guthmanny/feahi_rp2350/hardware/profiles/sp-1/README.md

# SP-1 单板 Profile

量产 **4L 单板** KiCad 工程：RP2350、ESP32-C6、MS1808/MS4344、8080 屏、键灯、接口与电源。

## KiCad

打开：**File → Open Project** →  
[hardware/profiles/sp-1/kicad/sp-1.kicad_pro](kicad/sp-1.kicad_pro)

子页：`core.kicad_sch`、`c6.kicad_sch`、`audio.kicad_sch`、`power.kicad_sch` 等。

## 原理图辅助文档

网表与 UI 分配见 [../b-c6/schematic/](../b-c6/schematic/)（`sp1_*.csv` / `sp1_*.md` 与单板共用）。
