guthmanny/feahi_rp2350/hardware/schematic/coreb_nets.csv

net | class | from | to | cbi_pin | notes
VBAT | power | CBI-1/2 | DCDC in | 1-2 | From Periph battery
+5V | power | CBI-3 | Optional sense/NC | 3
+3V3 | power | LDO out | CBI-4 | 5→Periph logic
GND | power | common | CBI-5..8 | 5-8
I2S_MCLK | digital | RP2350 I2S MCLK | CBI-9 | 9 | 24.576MHz XTL
I2S_BCLK | digital | RP2350 I2S BCLK | CBI-10 | 10
I2S_LRCLK | digital | RP2350 I2S LRCLK | CBI-11 | 11
I2S_DOUT | digital | RP2350 I2S SDOUT | CBI-12 | 12 | To MS4344
I2S_DIN | digital | CBI-13 | RP2350 I2S SDIN | 13 | From MS1808
HP_DETECT | digital | CBI-14 | RP2350 GPIO | 14
SPK_MUTE | digital | RP2350 GPIO | CBI-15 | 15
IPC_TX | digital | RP2350 UART TX | CBI-18 | 18 | To C6 RX
IPC_RX | digital | CBI-19 | RP2350 UART RX | 19 | From C6 TX
MIDI_TX | digital | RP2350 UART | CBI-21 | 21
MIDI_RX | digital | CBI-22 | RP2350 UART | 22
DEBUG_TX | digital | RP2350 UART0 | CBI-23 | 23 | USB-CDC or header
DEBUG_RX | digital | CBI-24 | RP2350 UART0 | 24
AUD_BOOT | digital | CBI-25 | RP2350 QSPI_SS / BOOTSEL | 25
NAND_CS | digital | RP2350 SPI CS | W25N01GV | — | On Core only
NAND_CLK | digital | RP2350 SPI SCK | W25N01GV | —
NAND_DQ0..3 | digital | RP2350 SPI IO | W25N01GV | — | Quad SPI optional
PSRAM_CS | digital | RP2350 QSPI CS | APS6404L | —
PSRAM_CLK | digital | RP2350 QSPI SCK | APS6404L | —
PSRAM_DQ0..3 | digital | RP2350 QSPI IO | APS6404L | —
USB_DP | digital | RP2350 USB | USB-C | —
USB_DM | digital | RP2350 USB | USB-C | —
