guthmanny/feahi_rp2350/hardware/profiles/b-c6/schematic/c6_gpio.csv

net | c6_gpio | module_pin | direction | peripheral | notes
LCD_DB0 | GPIO2 | IO2 | out | TFT020B107 FPC-7 | PARLIO data[0]
LCD_DB1 | GPIO3 | IO3 | out | TFT020B107 FPC-8
LCD_DB2 | GPIO14 | IO14 | out | TFT020B107 FPC-9
LCD_DB3 | GPIO20 | IO20 | out | TFT020B107 FPC-10
LCD_DB4 | GPIO21 | IO21 | out | TFT020B107 FPC-11
LCD_DB5 | GPIO22 | IO22 | out | TFT020B107 FPC-12
LCD_DB6 | GPIO23 | IO23 | out | TFT020B107 FPC-13
LCD_DB7 | GPIO19 | IO19 | out | TFT020B107 FPC-14
LCD_WR | GPIO18 | IO18 | out | TFT020B107 FPC-16 | PARLIO WR/CLK
LCD_RS | GPIO1 | IO1 | out | TFT020B107 FPC-17 | DC/RS
LCD_CS | GPIO0 | IO0 | out | TFT020B107 FPC-18
LCD_RST | GPIO15 | IO15 | out | TFT020B107 FPC-20 | 10k pull-up; strapping
LCD_BL | GPIO4 | IO4 | out | TFT020B107 FPC-1 | LEDA PWM via NPN; 10k PU strapping
LCD_RD | — | — | — | TFT020B107 FPC-15 | tie to IOVCC (write-only)
LCD_TE | GPIO8 | IO8 | in | TFT020B107 FPC-19 | TE 抗撕裂；输入无上下拉（模组推挽）
I2C_SDA | GPIO6 | IO6 | bidir | IS31FL3729 U18 only | 400kHz; 4.7k PU R73→3.3VD (R72 SCL)
I2C_SCL | GPIO7 | IO7 | out | IS31FL3729 U18
— | GPIO5 | IO5 | — | （NC） | Shift 指示改 U18 D30；释放 MTDI
POW_DET | GPIO12 | IO12 | in | 电源键（power 页） | 低=按下；R69→3.3VD；禁用 USB-JTAG
POW_CTL | GPIO13 | IO13 | out | MP2637 MODE 保持 | 高=保持 boost；R35 下拉；R36/D2 OR K1/D3
IPC_TX | GPIO16 | TXD0 | out | RP2350 GP5 (IPC_RX) | UART0 TX
IPC_RX | GPIO17 | RXD0 | in | RP2350 GP4 (IPC_TX) | UART0 RX
C6_BOOT | GPIO9 | IO9 | in | DNP 测试 pad only | 45k 模组内 PU；strapping
C6_EN | EN | EN | in | Reset RC | 10k PU + 100nF
C6_3V3 | 3V3 | 3 | pwr | +3V3 电源树 + bulk 10uF
C6_GND | GND | multiple | gnd | —
