guthmanny/feahi_rp2350/hardware/profiles/b-c6/schematic/sp1_u16_key_matrix.md

# Pad 键矩阵（已迁移）

**TCA9555 / U16 方案已废弃。** 当前定案：

→ **[sp1_rp2350_pad_matrix.md](sp1_rp2350_pad_matrix.md)**（RP2350 GPIO 直扫）  
→ **[sp1_key_matrix.csv](sp1_key_matrix.csv)**（键位与 `MAT_*` / GPIO 对照）

Choc、二极管方向、5×6 键位布局与旧版相同，仅 **MCU 侧** 改为 **U7 GPIO6–7、19–21、23–29**。
