guthmanny/feahi_rp2350/hardware/profiles/b-c6/schematic/sp1_u18_matrix_9x15.csv

# IS31FL3729 9×15 — 与 c6.kicad_sch 网表一致（2026-09-22 核对）
# A0h SWS=0000 → 9×15；占用 SW1–6、CS1–8
# 接法: A1/A2→CA(SW)=col+1；K1(R阴)→CB(CS)=row*2+2；K2(G阴)→CB(CS)=row*2+1
# PWM: reg = CS + scan_index(SW)*16（15×9 Fig.9）
#
key_label | matrix_row | matrix_col | led_ref | die | sw | cs | sch_anode_pin | sch_cathode_pin | u18_sym_anode | u18_sym_cathode | net_anode | net_cathode | pwm_reg_hex | notes
1 | 0 | 0 | D_PAD01 | R | 1 | 2 | A1 | K1 | CA1 | CB2 | U18_SW1 | U18_CS2 | 0x02 | c6 netlist OK
1 | 0 | 0 | D_PAD01 | G | 1 | 1 | A2 | K2 | CA1 | CB1 | U18_SW1 | U18_CS1 | 0x01 | c6 netlist OK
2 | 0 | 1 | D_PAD02 | R | 2 | 2 | A1 | K1 | CA2 | CB2 | U18_SW2 | U18_CS2 | 0x12 | c6 netlist OK
2 | 0 | 1 | D_PAD02 | G | 2 | 1 | A2 | K2 | CA2 | CB1 | U18_SW2 | U18_CS1 | 0x11 | c6 netlist OK
3 | 0 | 2 | D_PAD03 | R | 3 | 2 | A1 | K1 | CA3 | CB2 | U18_SW3 | U18_CS2 | 0x32 | c6 netlist OK
3 | 0 | 2 | D_PAD03 | G | 3 | 1 | A2 | K2 | CA3 | CB1 | U18_SW3 | U18_CS1 | 0x31 | c6 netlist OK
4 | 0 | 3 | D_PAD04 | R | 4 | 2 | A1 | K1 | CA4 | CB2 | U18_SW4 | U18_CS2 | 0x22 | c6 netlist OK
4 | 0 | 3 | D_PAD04 | G | 4 | 1 | A2 | K2 | CA4 | CB1 | U18_SW4 | U18_CS1 | 0x21 | c6 netlist OK
5 | 0 | 4 | D_PAD05 | R | 5 | 2 | A1 | K1 | CA5 | CB2 | U18_SW5 | U18_CS2 | 0x42 | c6 netlist OK
5 | 0 | 4 | D_PAD05 | G | 5 | 1 | A2 | K2 | CA5 | CB1 | U18_SW5 | U18_CS1 | 0x41 | c6 netlist OK
6 | 0 | 5 | D_PAD06 | R | 6 | 2 | A1 | K1 | CA6 | CB2 | U18_SW6 | U18_CS2 | 0x52 | c6 netlist OK
6 | 0 | 5 | D_PAD06 | G | 6 | 1 | A2 | K2 | CA6 | CB1 | U18_SW6 | U18_CS1 | 0x51 | c6 netlist OK
7 | 1 | 0 | D_PAD07 | R | 1 | 4 | A1 | K1 | CA1 | CB4 | U18_SW1 | U18_CS4 | 0x04 | c6 netlist OK
7 | 1 | 0 | D_PAD07 | G | 1 | 3 | A2 | K2 | CA1 | CB3 | U18_SW1 | U18_CS3 | 0x03 | c6 netlist OK
8 | 1 | 1 | D_PAD08 | R | 2 | 4 | A1 | K1 | CA2 | CB4 | U18_SW2 | U18_CS4 | 0x14 | c6 netlist OK
8 | 1 | 1 | D_PAD08 | G | 2 | 3 | A2 | K2 | CA2 | CB3 | U18_SW2 | U18_CS3 | 0x13 | c6 netlist OK
9 | 1 | 2 | D_PAD09 | R | 3 | 4 | A1 | K1 | CA3 | CB4 | U18_SW3 | U18_CS4 | 0x34 | c6 netlist OK
9 | 1 | 2 | D_PAD09 | G | 3 | 3 | A2 | K2 | CA3 | CB3 | U18_SW3 | U18_CS3 | 0x33 | c6 netlist OK
10 | 1 | 3 | D_PAD10 | R | 4 | 4 | A1 | K1 | CA4 | CB4 | U18_SW4 | U18_CS4 | 0x24 | c6 netlist OK
10 | 1 | 3 | D_PAD10 | G | 4 | 3 | A2 | K2 | CA4 | CB3 | U18_SW4 | U18_CS3 | 0x23 | c6 netlist OK
11 | 1 | 4 | D_PAD11 | R | 5 | 4 | A1 | K1 | CA5 | CB4 | U18_SW5 | U18_CS4 | 0x44 | c6 netlist OK
11 | 1 | 4 | D_PAD11 | G | 5 | 3 | A2 | K2 | CA5 | CB3 | U18_SW5 | U18_CS3 | 0x43 | c6 netlist OK
12 | 1 | 5 | D_PAD12 | R | 6 | 4 | A1 | K1 | CA6 | CB4 | U18_SW6 | U18_CS4 | 0x54 | c6 netlist OK
12 | 1 | 5 | D_PAD12 | G | 6 | 3 | A2 | K2 | CA6 | CB3 | U18_SW6 | U18_CS3 | 0x53 | c6 netlist OK
A | 2 | 0 | D_PAD13 | R | 1 | 6 | A1 | K1 | CA1 | CB6 | U18_SW1 | U18_CS6 | 0x06 | c6 netlist OK
A | 2 | 0 | D_PAD13 | G | 1 | 5 | A2 | K2 | CA1 | CB5 | U18_SW1 | U18_CS5 | 0x05 | c6 netlist OK
B | 2 | 1 | D_PAD14 | R | 2 | 6 | A1 | K1 | CA2 | CB6 | U18_SW2 | U18_CS6 | 0x16 | c6 netlist OK
B | 2 | 1 | D_PAD14 | G | 2 | 5 | A2 | K2 | CA2 | CB5 | U18_SW2 | U18_CS5 | 0x15 | c6 netlist OK
C | 2 | 2 | D_PAD15 | R | 3 | 6 | A1 | K1 | CA3 | CB6 | U18_SW3 | U18_CS6 | 0x36 | c6 netlist OK
C | 2 | 2 | D_PAD15 | G | 3 | 5 | A2 | K2 | CA3 | CB5 | U18_SW3 | U18_CS5 | 0x35 | c6 netlist OK
D | 2 | 3 | D_PAD16 | R | 4 | 6 | A1 | K1 | CA4 | CB6 | U18_SW4 | U18_CS6 | 0x26 | c6 netlist OK
D | 2 | 3 | D_PAD16 | G | 4 | 5 | A2 | K2 | CA4 | CB5 | U18_SW4 | U18_CS5 | 0x25 | c6 netlist OK
REC | 2 | 4 | D_PAD17 | R | 5 | 6 | A1 | K1 | CA5 | CB6 | U18_SW5 | U18_CS6 | 0x46 | c6 netlist OK
REC | 2 | 4 | D_PAD17 | G | 5 | 5 | A2 | K2 | CA5 | CB5 | U18_SW5 | U18_CS5 | 0x45 | c6 netlist OK
PLAY | 2 | 5 | D_PAD18 | R | 6 | 6 | A1 | K1 | CA6 | CB6 | U18_SW6 | U18_CS6 | 0x56 | c6 netlist OK
PLAY | 2 | 5 | D_PAD18 | G | 6 | 5 | A2 | K2 | CA6 | CB5 | U18_SW6 | U18_CS5 | 0x55 | c6 netlist OK
PATTERN | 3 | 0 | D_PAD19 | R | 1 | 8 | A1 | K1 | CA1 | CB8 | U18_SW1 | U18_CS8 | 0x08 | c6 netlist OK
PATTERN | 3 | 0 | D_PAD19 | G | 1 | 7 | A2 | K2 | CA1 | CB7 | U18_SW1 | U18_CS7 | 0x07 | c6 netlist OK
SAMPLE | 3 | 1 | D_PAD20 | R | 2 | 8 | A1 | K1 | CA2 | CB8 | U18_SW2 | U18_CS8 | 0x18 | c6 netlist OK
SAMPLE | 3 | 1 | D_PAD20 | G | 2 | 7 | A2 | K2 | CA2 | CB7 | U18_SW2 | U18_CS7 | 0x17 | c6 netlist OK
SHIFT | 4 | 1 | D30 | 0402 | 7 | 9 | A | K | CA7 | CB9 | — | — | 0x79 | Shift 指示 0402 单色；键仍 RP2350 扫描
