guthmanny/feahi_rp2350/hardware/profiles/sp-1/kicad/c6_i2c_export.pdf

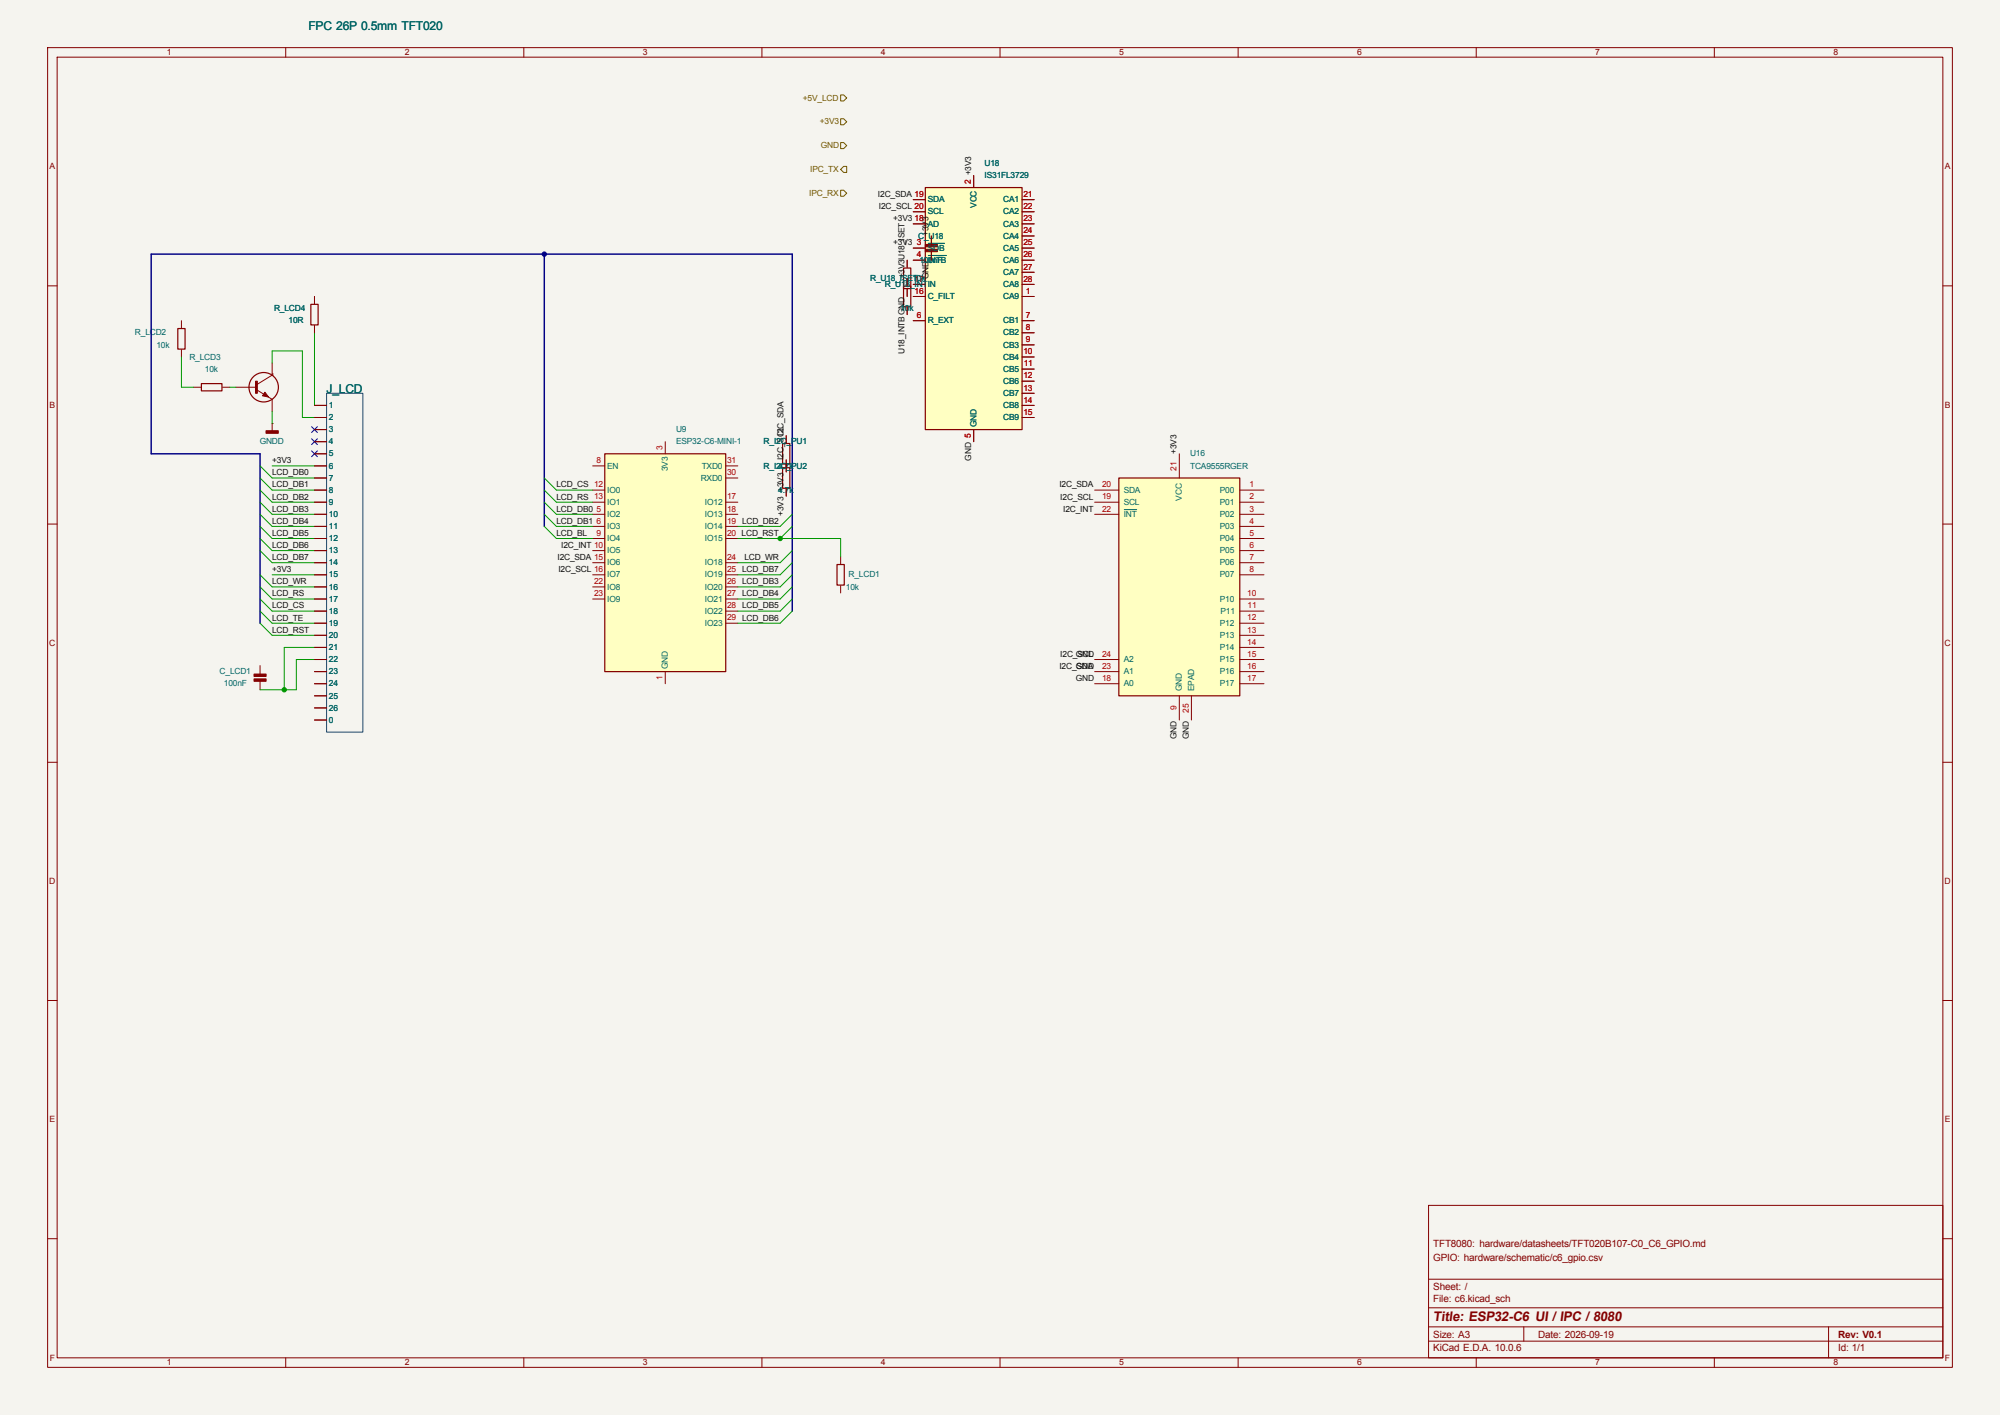
[picture p1: page 1]

File: c6.kicad_sch Sheet: / GPIO: hardware/schematic/c6_gpio.csv TFT8080: hardware/datasheets/TFT020B107-C0_C6_GPIO.md

Id: 1/1 Title: ESP32-C6 UI / IPC / 8080
