guthmanny/feahi_rp2350/hardware/profiles/sp-1/kicad/sp-1.kicad_pcb

## KiCad design hardware/profiles/sp-1/kicad/sp-1.kicad_pcb (2026-10-31)

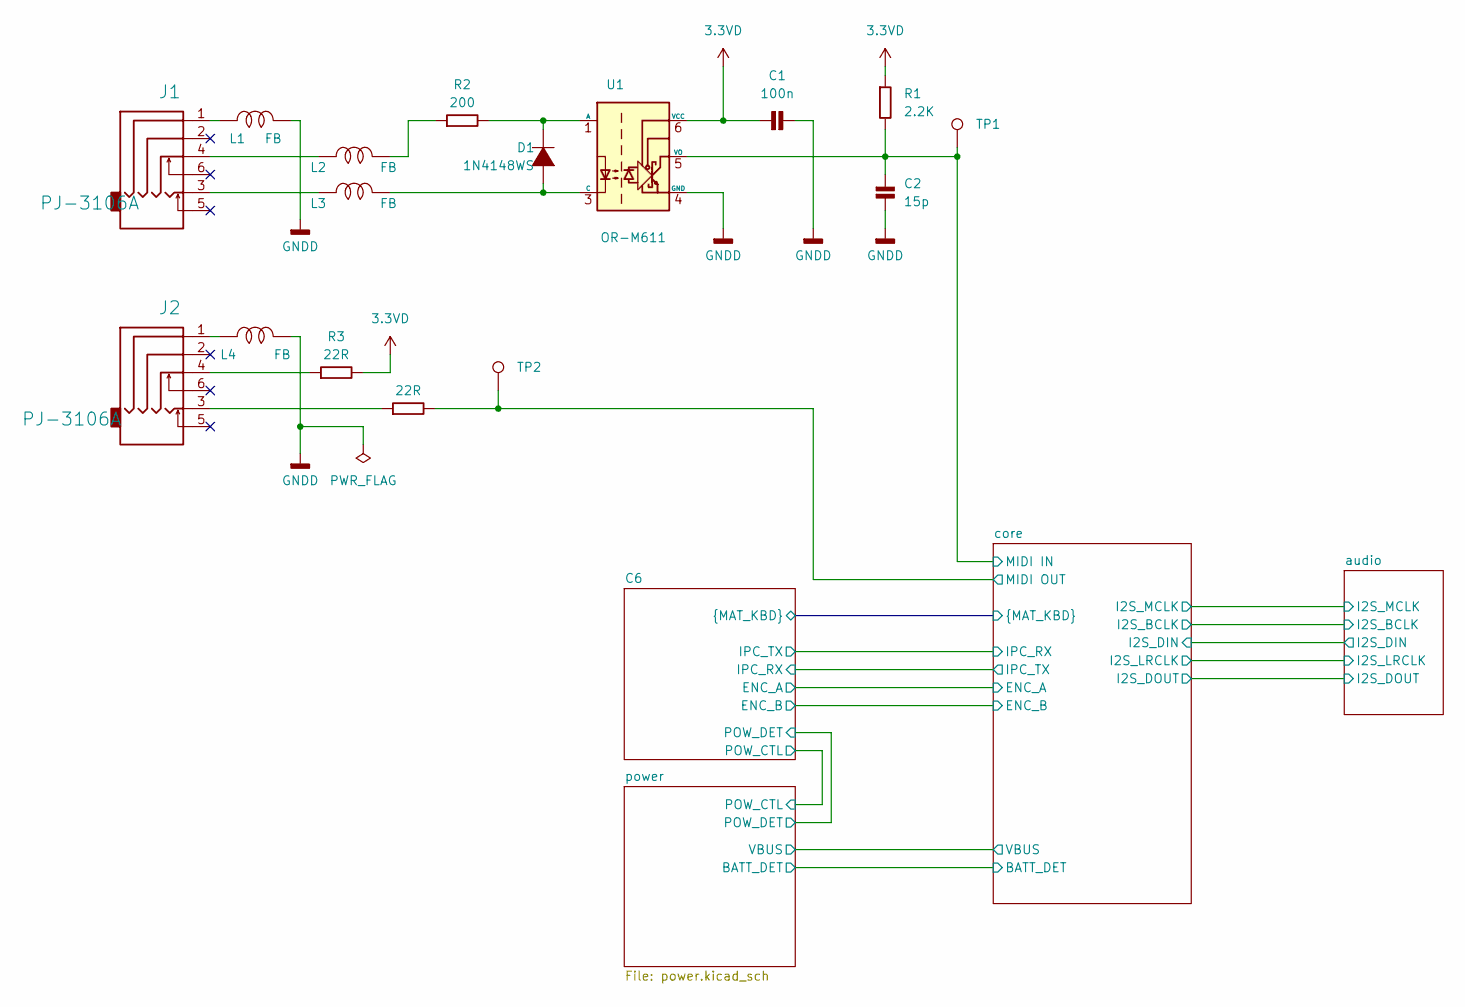
[picture p3: schematic sp-1.kicad_sch]

Parts:
C1: 100n; C_0402_1005Metric_Pad0.74x0.62mm_HandSolder
C2: 15p; C_0402_1005Metric_Pad0.74x0.62mm_HandSolder
D1: 1N4148WS; SOD-323
J1, J2: PJ-3106A; PJ3106A
L1, L2, L3, L4: FB; L_0603_1608Metric
R1: 2.2K; R_0402_1005Metric_Pad0.72x0.64mm_HandSolder
R2: 200; R_0402_1005Metric_Pad0.72x0.64mm_HandSolder
R3, R4: 22R; R_0402_1005Metric_Pad0.72x0.64mm_HandSolder
TP1: TP; TEST POINT
TP2: TP; TestPoint_Keystone_5000-5004_Miniature
U1: OR-M611; SO-5-6_4.55x3.7mm_P1.27mm; Part Number OR-M611-TP-G-(HB)

Connections:
3.3VD: C1.1, R1.1, R3.2, U1.6 (VCC); also elsewhere on the board
/core/MIDI IN: C2.1, R1.2, TP1.1 (1_1), U1.5 (VO); also elsewhere on the board
/core/MIDI OUT: R4.2, TP2.1 (1_1); also elsewhere on the board
GNDD: C1.2, C2.2, L1.2, L4.2, U1.4 (GND); also elsewhere on the board
unnamed: D1.1 (A), L3.2, U1.3 (C)
unnamed: D1.2 (K), R2.2, U1.1 (A)
unnamed: J1.1, L1.1
unnamed: J1.3, L3.1
unnamed: J1.4, L2.1
unnamed: J2.1, L4.1
unnamed: J2.3, R4.1
unnamed: J2.4, R3.1
unnamed: L2.2, R2.1

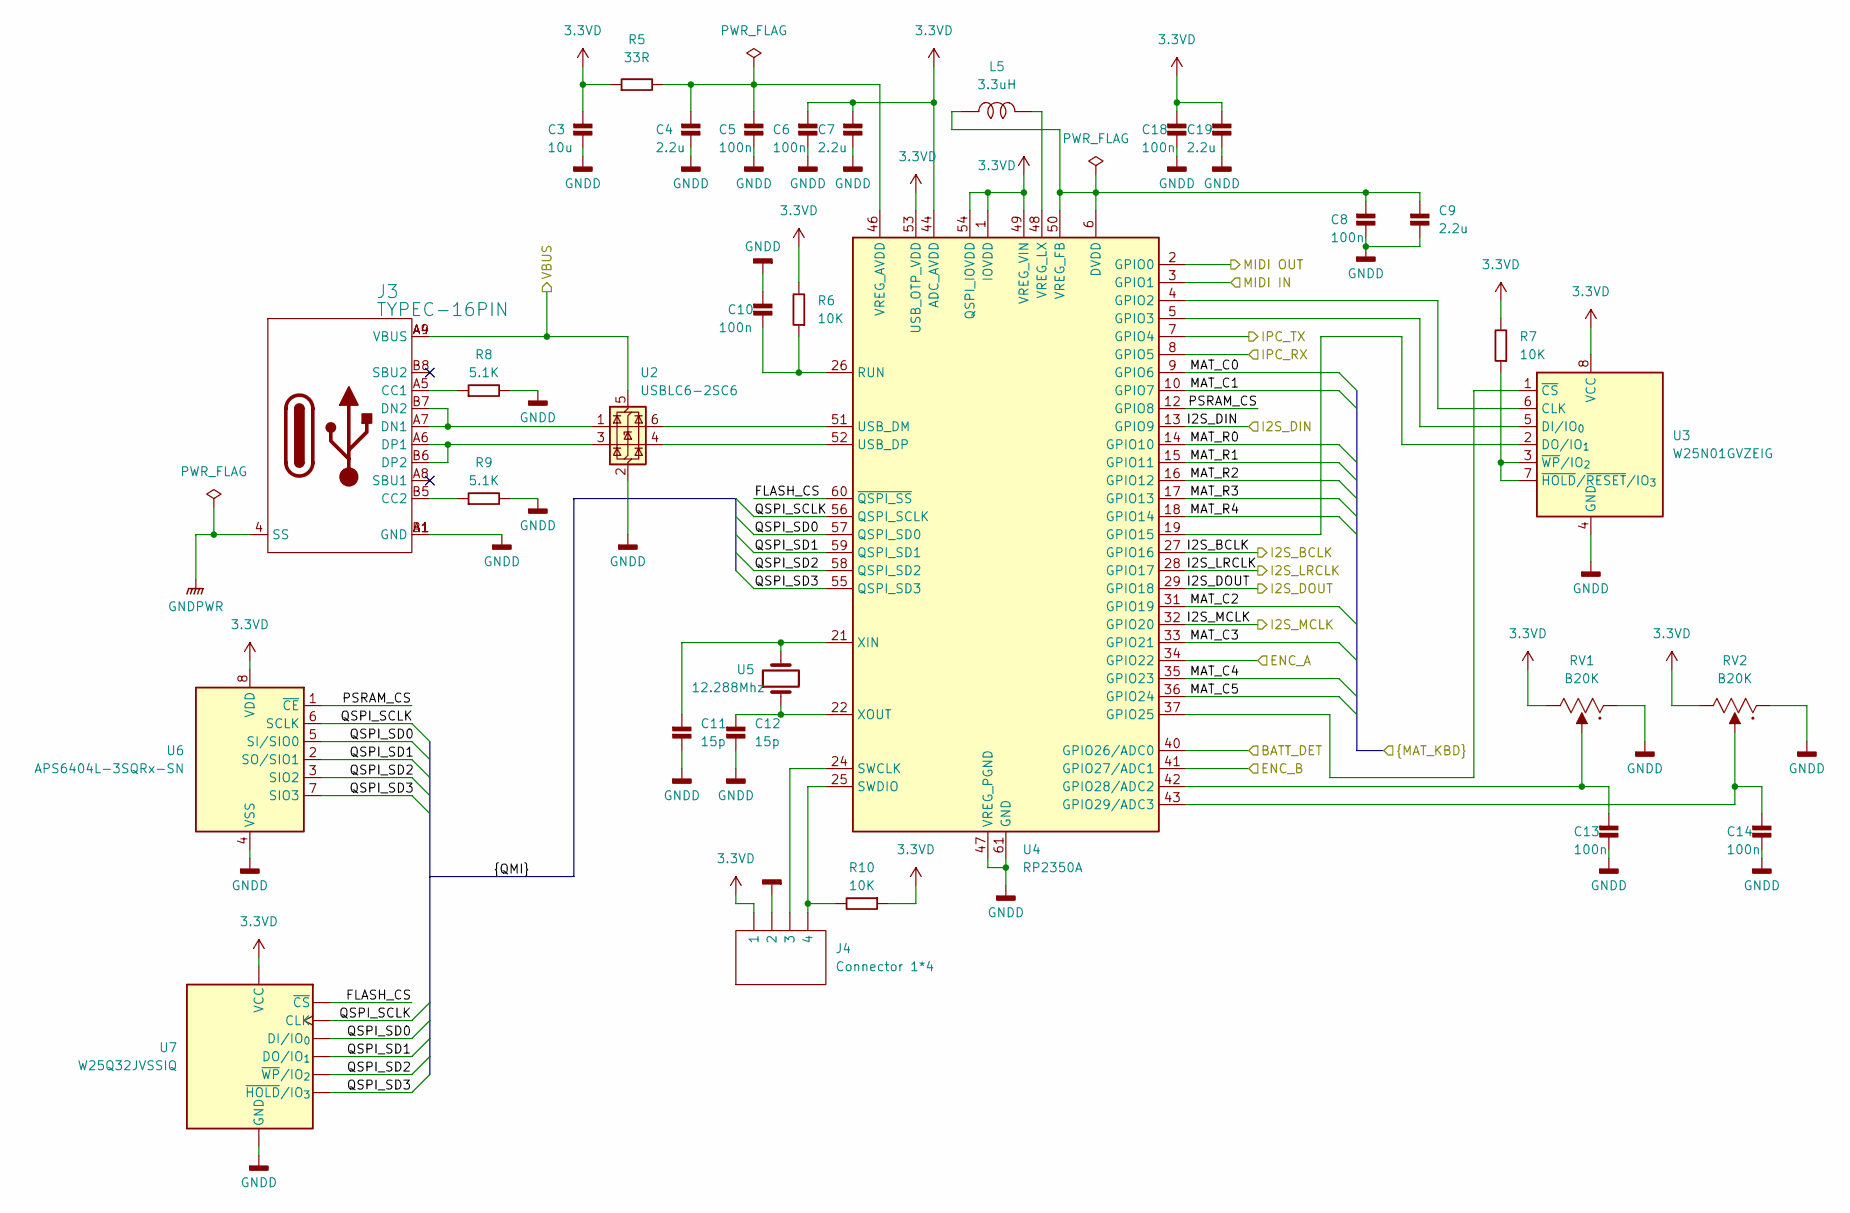
[picture p4: schematic core.kicad_sch]

Parts:
C3: 10u; C_0603_1608Metric_Pad1.08x0.95mm_HandSolder
C4, C7, C9, C19: 2.2u; C_0402_1005Metric_Pad0.74x0.62mm_HandSolder
C5, C6, C8, C10, C13, C14, C18: 100n; C_0402_1005Metric_Pad0.74x0.62mm_HandSolder
C11, C12: 15p; C_0402_1005Metric_Pad0.74x0.62mm_HandSolder
J3: TYPEC-16PIN; TYPEC-PIN12
J4: Connector 1*4; CN2.54P4
L5: 3.3uH; L_Cenker_CKCS201610
R5: 33R; R_0603_1608Metric_Pad0.98x0.95mm_HandSolder
R6, R7, R10: 10K; R_0402_1005Metric_Pad0.72x0.64mm_HandSolder
R8, R9: 5.1K; R_0402_1005Metric_Pad0.72x0.64mm_HandSolder
RV1, RV2: B20K; 9MM V POT_7.5mm
U2: USBLC6-2SC6; SOT-23-6
U3: W25N01GVZEIG; WSON-8-1EP_8x6mm_P1.27mm_EP3.4x4.3mm
U4: RP2350A; QFN-60-1EP_7x7mm_P0.4mm_EP3.4x3.4mm
U5: 12.288Mhz; Crystal_SMD_3225-4Pin_3.2x2.5mm
U6: APS6404L-3SQRx-SN; SOIC-8_3.9x4.9mm_P1.27mm
U7: W25Q32JVSSIQ; SOIC-8_5.3x5.3mm_P1.27mm; Part Number W25Q32JVSSIQ

Connections:
3.3VD: C3.1, C6.1, C7.1, C18.1, C19.1, J4.1, R5.1, R6.2, R7.2, R10.1, RV1.3, RV2.3, U3.8 (VCC), U4.1 (IOVDD), U4.11 (IOVDD), U4.20 (IOVDD), U4.30 (IOVDD), U4.38 (IOVDD), U4.44 (ADC_AVDD), U4.45 (IOVDD), U4.49 (VREG_VIN), U4.53 (USB_OTP_VDD), U4.54 (QSPI_IOVDD), U6.8 (VDD), U7.8 (VCC); also elsewhere on the board
/C6/ENC_A: U4.34 (GPIO22)
/C6/ENC_B: U4.41 (GPIO27/ADC1)
/C6/IPC_RX: U4.7 (GPIO4); also elsewhere on the board
/C6/IPC_TX: U4.8 (GPIO5); also elsewhere on the board
/C6/MAT_C0: U4.9 (GPIO6); also elsewhere on the board
/C6/MAT_C1: U4.10 (GPIO7); also elsewhere on the board
/C6/MAT_C2: U4.31 (GPIO19); also elsewhere on the board
/C6/MAT_C3: U4.33 (GPIO21); also elsewhere on the board
/C6/MAT_C4: U4.35 (GPIO23); also elsewhere on the board
/C6/MAT_C5: U4.36 (GPIO24); also elsewhere on the board
/C6/MAT_R0: U4.14 (GPIO10); also elsewhere on the board
/C6/MAT_R1: U4.15 (GPIO11); also elsewhere on the board
/C6/MAT_R2: U4.16 (GPIO12); also elsewhere on the board
/C6/MAT_R3: U4.17 (GPIO13); also elsewhere on the board
/C6/MAT_R4: U4.18 (GPIO14); also elsewhere on the board
/audio/I2S_BCLK: U4.27 (GPIO16); also elsewhere on the board
/audio/I2S_DIN: U4.13 (GPIO9); also elsewhere on the board
/audio/I2S_DOUT: U4.29 (GPIO18); also elsewhere on the board
/audio/I2S_LRCLK: U4.28 (GPIO17); also elsewhere on the board
/audio/I2S_MCLK: U4.32 (GPIO20); also elsewhere on the board
/core/BATT_DET: U4.40 (GPIO26/ADC0); also elsewhere on the board
/core/FLASH_CS: U4.60 (~QSPI_SS), U7.1 (~CS)
/core/MIDI IN: U4.3 (GPIO1); also elsewhere on the board
/core/MIDI OUT: U4.2 (GPIO0); also elsewhere on the board
/core/PSRAM_CS: U4.12 (GPIO8), U6.1 (~CE)
/core/QSPI_SCLK: U4.56 (QSPI_SCLK), U6.6 (SCLK), U7.6 (CLK)
/core/QSPI_SD0: U4.57 (QSPI_SD0), U6.5 (SI/SIO0), U7.5 (DI/IO_{0})
/core/QSPI_SD1: U4.59 (QSPI_SD1), U6.2 (SO/SIO1), U7.2 (DO/IO_{1})
/core/QSPI_SD2: U4.58 (QSPI_SD2), U6.3 (SIO2), U7.3 (~WP/IO_{2})
/core/QSPI_SD3: U4.55 (QSPI_SD3), U6.7 (SIO3), U7.7 (~HOLD/IO_{3})
/core/VBUS: J3.A4 (VBUS), J3.A9 (VBUS), J3.B4 (VBUS), J3.B9 (VBUS), U2.5 (VBUS); also elsewhere on the board
GNDD: C3.2, C4.2, C5.2, C6.2, C7.2, C8.2, C9.2, C10.1, C11.2, C12.2, C13.2, C14.2, C18.2, C19.2, J3.A1 (GND), J3.A12 (GND), J3.B1 (GND), J3.B12 (GND), J4.2, R8.2, R9.2, RV1.1, RV2.1, U2.2 (GND), U3.4 (GND), U4.47 (VREG_PGND), U4.61 (GND), U6.4 (VSS), U7.4 (GND); also elsewhere on the board
GNDPWR: J3.1 (SS), J3.2 (SS), J3.3 (SS), J3.4 (SS); also elsewhere on the board
unnamed: J3.A5 (CC1), R8.1
unnamed: J3.B5 (CC2), R9.1
unnamed: J3.A7 (DN1), J3.B7 (DN2), U2.1 (I/O1)
unnamed: J3.A6 (DP1), J3.B6 (DP2), U2.3 (I/O2)
unnamed: U3.6 (CLK), U4.4 (GPIO2)
unnamed: U3.5 (DI/IO_{0}), U4.5 (GPIO3)
unnamed: U3.2 (DO/IO_{1}), U4.19 (GPIO15)
unnamed: U3.1 (~CS), U4.37 (GPIO25)
unnamed: R7.1, U3.3 (~WP/IO_{2}), U3.7 (~HOLD/~RESET/IO_{3})
unnamed: C13.1, RV1.2, U4.42 (GPIO28/ADC2)
unnamed: C14.1, RV2.2, U4.43 (GPIO29/ADC3)
unnamed: C10.2, R6.1, U4.26 (RUN)
unnamed: J4.3, U4.24 (SWCLK)
unnamed: J4.4, R10.2, U4.25 (SWDIO)
unnamed: U2.6 (I/O1), U4.51 (USB_DM)
unnamed: U2.4 (I/O2), U4.52 (USB_DP)
unnamed: C4.1, C5.1, R5.2, U4.46 (VREG_AVDD)
unnamed: C8.1, C9.1, L5.1, U4.6 (DVDD), U4.23 (DVDD), U4.39 (DVDD), U4.50 (VREG_FB)
unnamed: L5.2, U4.48 (VREG_LX)
unnamed: C11.1, U4.21 (XIN), U5.2
unnamed: C12.1, U4.22 (XOUT), U5.1

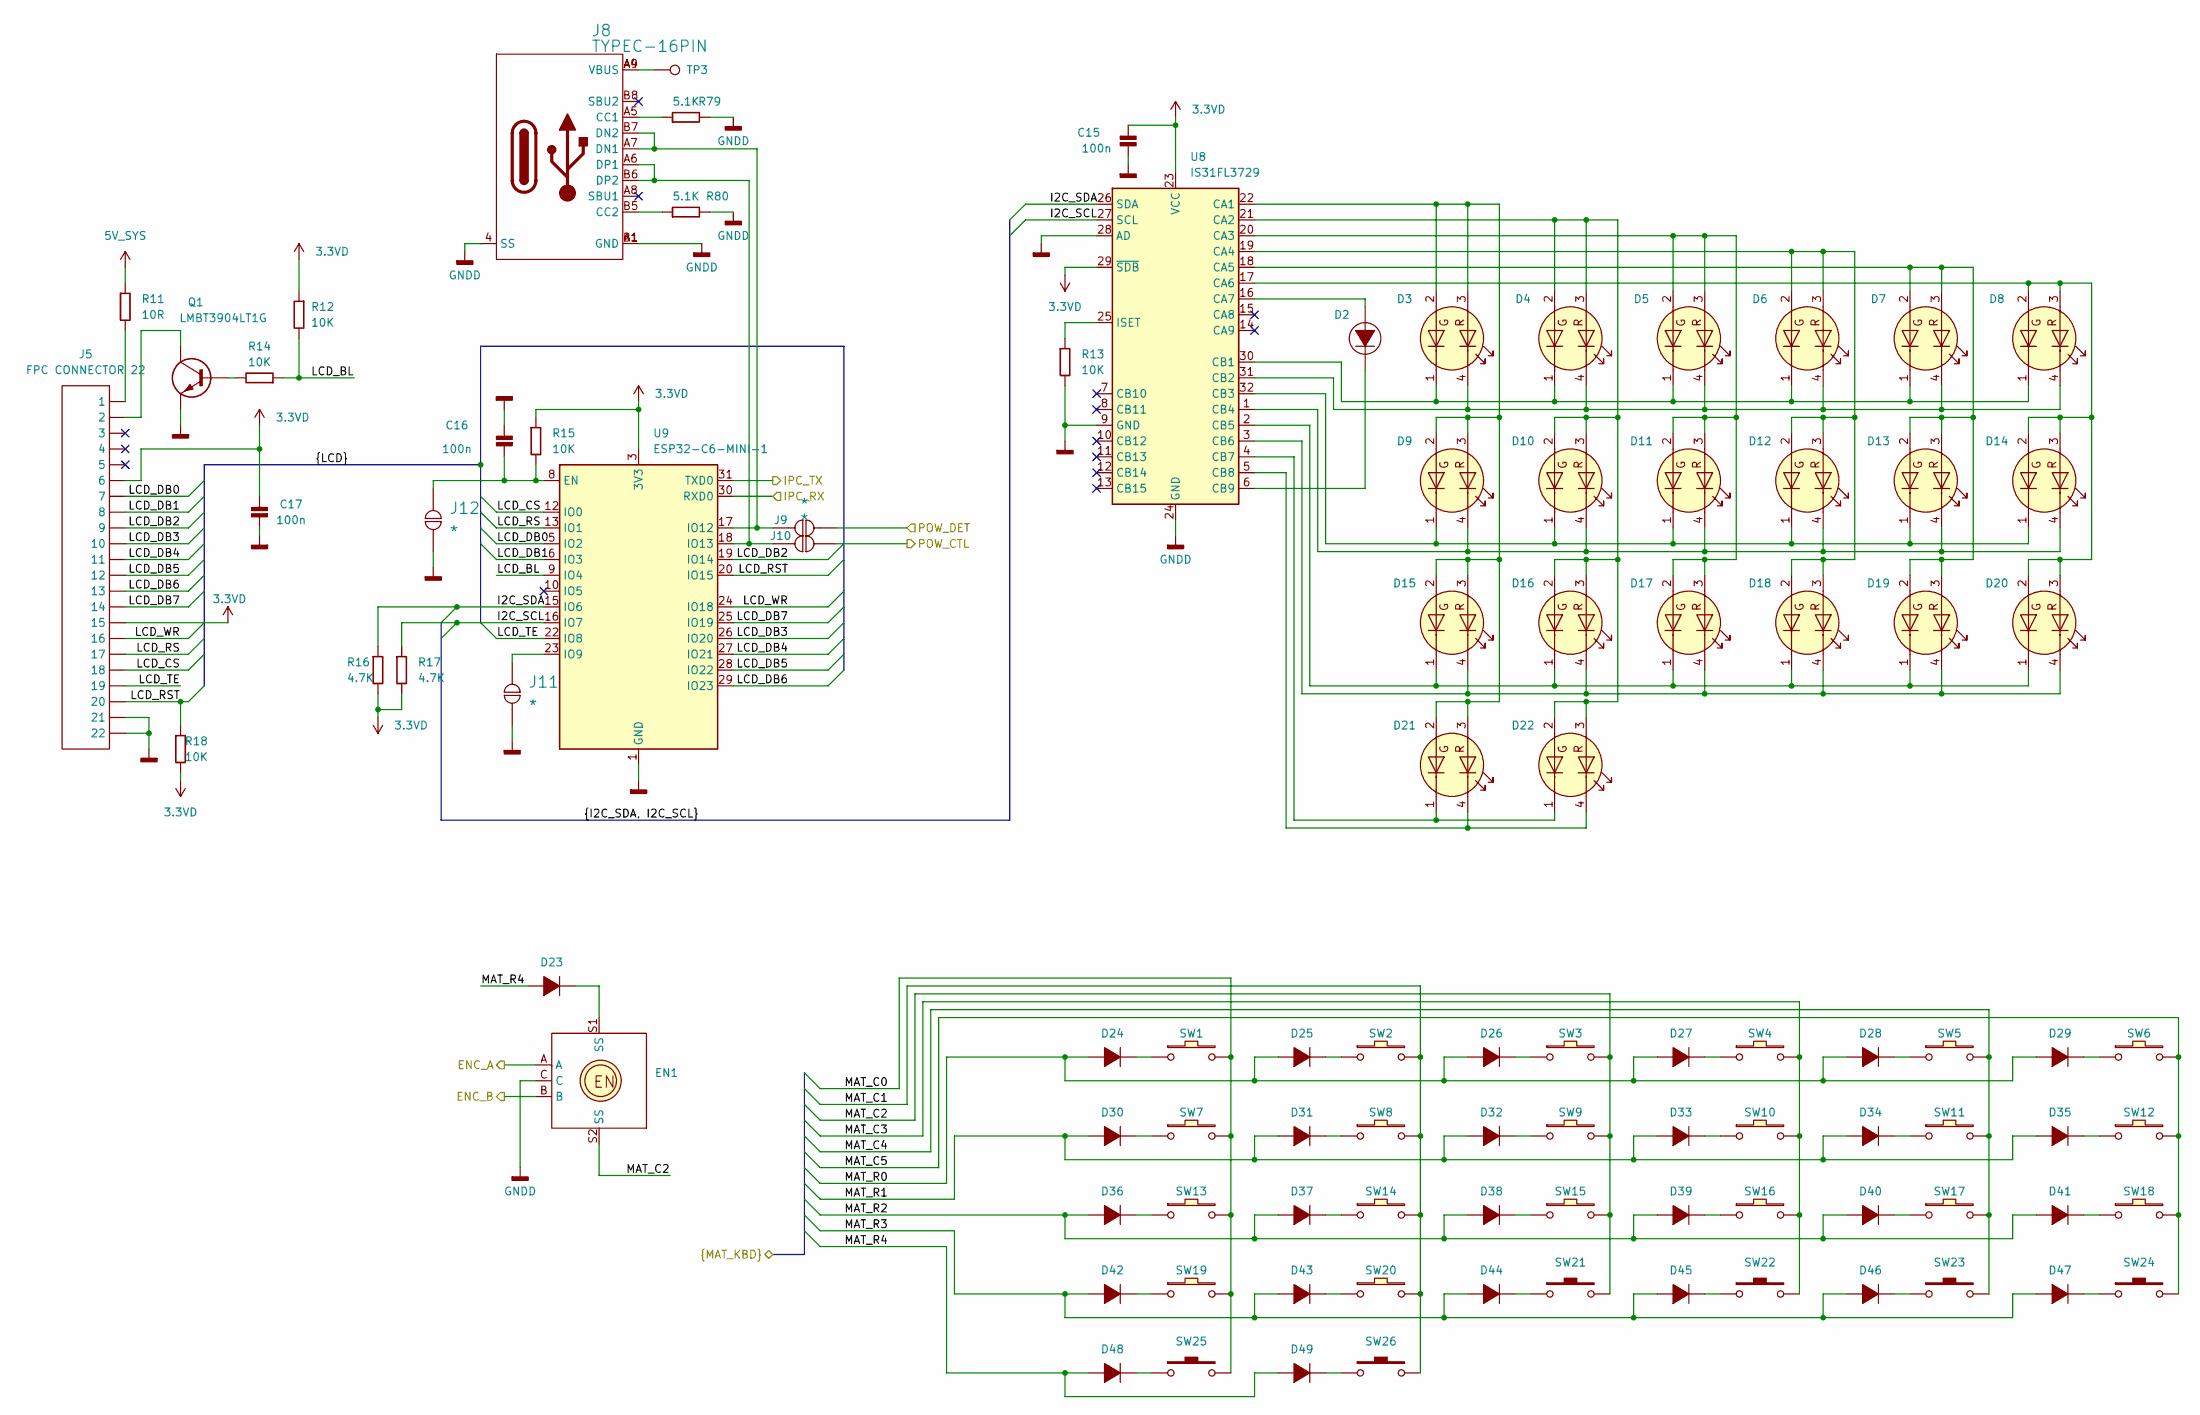
[picture p5: schematic c6.kicad_sch, ESP32-C6 UI / IPC / 8080]

Parts:
C15, C16, C17: 100n; C_0402_1005Metric_Pad0.74x0.62mm_HandSolder
D2: 0402 LED; LED0402
D3, D4, D5, D6, D7, D8, D9, D10, D11, D12, D13, D14, D15, D16, D17, D18, D19, D20, D21, D22: LTST-C235KGKRKT; LED_LiteOn_LTST-C235KGKRKT
D23, D24, D25, D26, D27, D28, D29, D30, D31, D32, D33, D34, D35, D36, D37, D38, D39, D40, D41, D42, D43, D44, D45, D46, D47, D48, D49: 1N4148WS; SOD-323
EN1: TEMPO; 11mm Encoder
J5: FPC CONNECTOR 22; 22PIN_FPCZ
J8: TYPEC-16PIN; TYPEC-PIN12
J9, J10, J11, J12: *; BYPASS
Q1: LMBT3904LT1G; SOT-23
R11: 10R; R_0402_1005Metric_Pad0.72x0.64mm_HandSolder
R12, R13, R14, R15, R18: 10K; R_0402_1005Metric_Pad0.72x0.64mm_HandSolder
R16, R17: 4.7K; R_0402_1005Metric_Pad0.72x0.64mm_HandSolder
R79, R80: 5.1K; R_0402_1005Metric_Pad0.72x0.64mm_HandSolder
SW1, SW2, SW3, SW4, SW5, SW6, SW7, SW8, SW9, SW10, SW11, SW12, SW13, SW14, SW15, SW16, SW17, SW18, SW19, SW20: CPG1353; SW_Kailh_Choc_V2
SW21, SW22, SW23, SW24, SW25, SW26: SMD TACT SWITCH; SW-T-SMT - 1
TP3: TP; TEST POINT
U8: IS31FL3729; QFN-32
U9: ESP32-C6-MINI-1

Connections:
3.3VD: C15.1, C17.1, J5.6, J5.15, R12.1, R15.1, R16.2, R17.2, R18.2, U8.23 (VCC), U8.29 (~SDB), U9.3 (3V3); also elsewhere on the board
5V_SYS: R11.1; also elsewhere on the board
/C6/I2C_SCL: R17.1, U8.27 (SCL), U9.16 (IO7)
/C6/I2C_SDA: R16.1, U8.26 (SDA), U9.15 (IO6)
/C6/IPC_RX: U9.30 (RXD0); also elsewhere on the board
/C6/IPC_TX: U9.31 (TXD0); also elsewhere on the board
/C6/LCD_BL: R12.2, R14.1, U9.9 (IO4)
/C6/LCD_CS: J5.18, U9.12 (IO0)
/C6/LCD_DB0: J5.7, U9.5 (IO2)
/C6/LCD_DB1: J5.8, U9.6 (IO3)
/C6/LCD_DB2: J5.9, U9.19 (IO14)
/C6/LCD_DB3: J5.10, U9.26 (IO20)
/C6/LCD_DB4: J5.11, U9.27 (IO21)
/C6/LCD_DB5: J5.12, U9.28 (IO22)
/C6/LCD_DB6: J5.13, U9.29 (IO23)
/C6/LCD_DB7: J5.14, U9.25 (IO19)
/C6/LCD_RS: J5.17, U9.13 (IO1)
/C6/LCD_RST: J5.20, R18.1, U9.20 (IO15)
/C6/LCD_TE: J5.19, U9.22 (IO8)
/C6/LCD_WR: J5.16, U9.24 (IO18)
/C6/MAT_C0: SW1.2, SW7.2, SW13.2, SW19.2, SW25.2; also elsewhere on the board
/C6/MAT_C1: SW2.2, SW8.2, SW14.2, SW20.2, SW26.2; also elsewhere on the board
/C6/MAT_C2: EN1.S2 (SS), SW3.2, SW9.2, SW15.2, SW21.2; also elsewhere on the board
/C6/MAT_C3: SW4.2, SW10.2, SW16.2, SW22.2; also elsewhere on the board
/C6/MAT_C4: SW5.2, SW11.2, SW17.2, SW23.2; also elsewhere on the board
/C6/MAT_C5: SW6.2, SW12.2, SW18.2, SW24.2; also elsewhere on the board
/C6/MAT_R0: D24.1 (A), D25.1 (A), D26.1 (A), D27.1 (A), D28.1 (A), D29.1 (A); also elsewhere on the board
/C6/MAT_R1: D30.1 (A), D31.1 (A), D32.1 (A), D33.1 (A), D34.1 (A), D35.1 (A); also elsewhere on the board
/C6/MAT_R2: D36.1 (A), D37.1 (A), D38.1 (A), D39.1 (A), D40.1 (A), D41.1 (A); also elsewhere on the board
/C6/MAT_R3: D42.1 (A), D43.1 (A), D44.1 (A), D45.1 (A), D46.1 (A), D47.1 (A); also elsewhere on the board
/C6/MAT_R4: D23.1 (A), D48.1 (A), D49.1 (A); also elsewhere on the board
/C6/POW_CTL: J10.2; also elsewhere on the board
/C6/POW_DET: J9.2; also elsewhere on the board
GNDD: C15.2, C16.1, C17.2, EN1.C, J5.21, J5.22, J8.1 (SS), J8.2 (SS), J8.3 (SS), J8.4 (SS), J8.A1 (GND), J8.A12 (GND), J8.B1 (GND), J8.B12 (GND), J11.1, J12.1, Q1.2 (E), R13.2, R79.2, R80.2, U8.9 (GND), U8.24 (GND), U8.28 (AD), U8.33 (GNDD), U9.1 (GND), U9.2 (GND), U9.11 (GND), U9.14 (GND), U9.36 (GND), U9.37 (GND), U9.38 (GND), U9.39 (GND), U9.40 (GND), U9.41 (GND), U9.42 (GND), U9.43 (GND), U9.44 (GND), U9.45 (GND), U9.46 (GND), U9.47 (GND), U9.48 (GND), U9.49 (GND), U9.50 (GND), U9.51 (GND), U9.52 (GND), U9.53 (GND); also elsewhere on the board
unnamed: D2.K (1), U8.6 (CB9)
unnamed: D2.A (2), U8.16 (CA7)
unnamed: D3.4 (K1), D4.4 (K1), D5.4 (K1), D6.4 (K1), D7.4 (K1), D8.4 (K1), U8.31 (CB2)
unnamed: D3.1 (K2), D4.1 (K2), D5.1 (K2), D6.1 (K2), D7.1 (K2), D8.1 (K2), U8.30 (CB1)
unnamed: D4.2 (A2), D4.3 (A1), D10.2 (A2), D10.3 (A1), D16.2 (A2), D16.3 (A1), D22.2 (A2), D22.3 (A1), U8.21 (CA2)
unnamed: D9.4 (K1), D10.4 (K1), D11.4 (K1), D12.4 (K1), D13.4 (K1), D14.4 (K1), U8.1 (CB4)
unnamed: D9.1 (K2), D10.1 (K2), D11.1 (K2), D12.1 (K2), D13.1 (K2), D14.1 (K2), U8.32 (CB3)
unnamed: D5.2 (A2), D5.3 (A1), D11.2 (A2), D11.3 (A1), D17.2 (A2), D17.3 (A1), U8.20 (CA3)
unnamed: D6.2 (A2), D6.3 (A1), D12.2 (A2), D12.3 (A1), D18.2 (A2), D18.3 (A1), U8.19 (CA4)
unnamed: D7.2 (A2), D7.3 (A1), D13.2 (A2), D13.3 (A1), D19.2 (A2), D19.3 (A1), U8.18 (CA5)
unnamed: D8.2 (A2), D8.3 (A1), D14.2 (A2), D14.3 (A1), D20.2 (A2), D20.3 (A1), U8.17 (CA6)
unnamed: D3.2 (A2), D3.3 (A1), D9.2 (A2), D9.3 (A1), D15.2 (A2), D15.3 (A1), D21.2 (A2), D21.3 (A1), U8.22 (CA1)
unnamed: D15.4 (K1), D16.4 (K1), D17.4 (K1), D18.4 (K1), D19.4 (K1), D20.4 (K1), U8.3 (CB6)
unnamed: D15.1 (K2), D16.1 (K2), D17.1 (K2), D18.1 (K2), D19.1 (K2), D20.1 (K2), U8.2 (CB5)
unnamed: D21.4 (K1), D22.4 (K1), U8.5 (CB8)
unnamed: D21.1 (K2), D22.1 (K2), U8.4 (CB7)
unnamed: D23.2 (K), EN1.S1 (SS)
unnamed: D24.2 (K), SW1.1
unnamed: D25.2 (K), SW2.1
unnamed: D26.2 (K), SW3.1
unnamed: D27.2 (K), SW4.1
unnamed: D28.2 (K), SW5.1
unnamed: D29.2 (K), SW6.1
unnamed: D30.2 (K), SW7.1
unnamed: D31.2 (K), SW8.1
unnamed: D32.2 (K), SW9.1
unnamed: D33.2 (K), SW10.1
unnamed: D34.2 (K), SW11.1
unnamed: D35.2 (K), SW12.1
unnamed: D36.2 (K), SW13.1
unnamed: D37.2 (K), SW14.1
unnamed: D38.2 (K), SW15.1
unnamed: D39.2 (K), SW16.1
unnamed: D40.2 (K), SW17.1
unnamed: D41.2 (K), SW18.1
unnamed: D42.2 (K), SW19.1
unnamed: D43.2 (K), SW20.1
unnamed: D44.2 (K), SW21.1
unnamed: D45.2 (K), SW22.1
unnamed: D46.2 (K), SW23.1
unnamed: D47.2 (K), SW24.1
unnamed: D48.2 (K), SW25.1
unnamed: D49.2 (K), SW26.1
unnamed: J5.1, R11.2
unnamed: J8.A5 (CC1), R79.1
unnamed: J8.B5 (CC2), R80.1
unnamed: J8.A7 (DN1), J8.B7 (DN2), J9.1, U9.17 (IO12)
unnamed: J8.A6 (DP1), J8.B6 (DP2), J10.1, U9.18 (IO13)
unnamed: J8.A4 (VBUS), J8.A9 (VBUS), J8.B4 (VBUS), J8.B9 (VBUS), TP3.1 (1_1)
unnamed: Q1.1 (B), R14.2
unnamed: J5.2, Q1.3 (C)
unnamed: R13.1, U8.25 (ISET)
unnamed: C16.2, J12.2, R15.2, U9.8 (EN)
unnamed: J11.2, U9.23 (IO9)

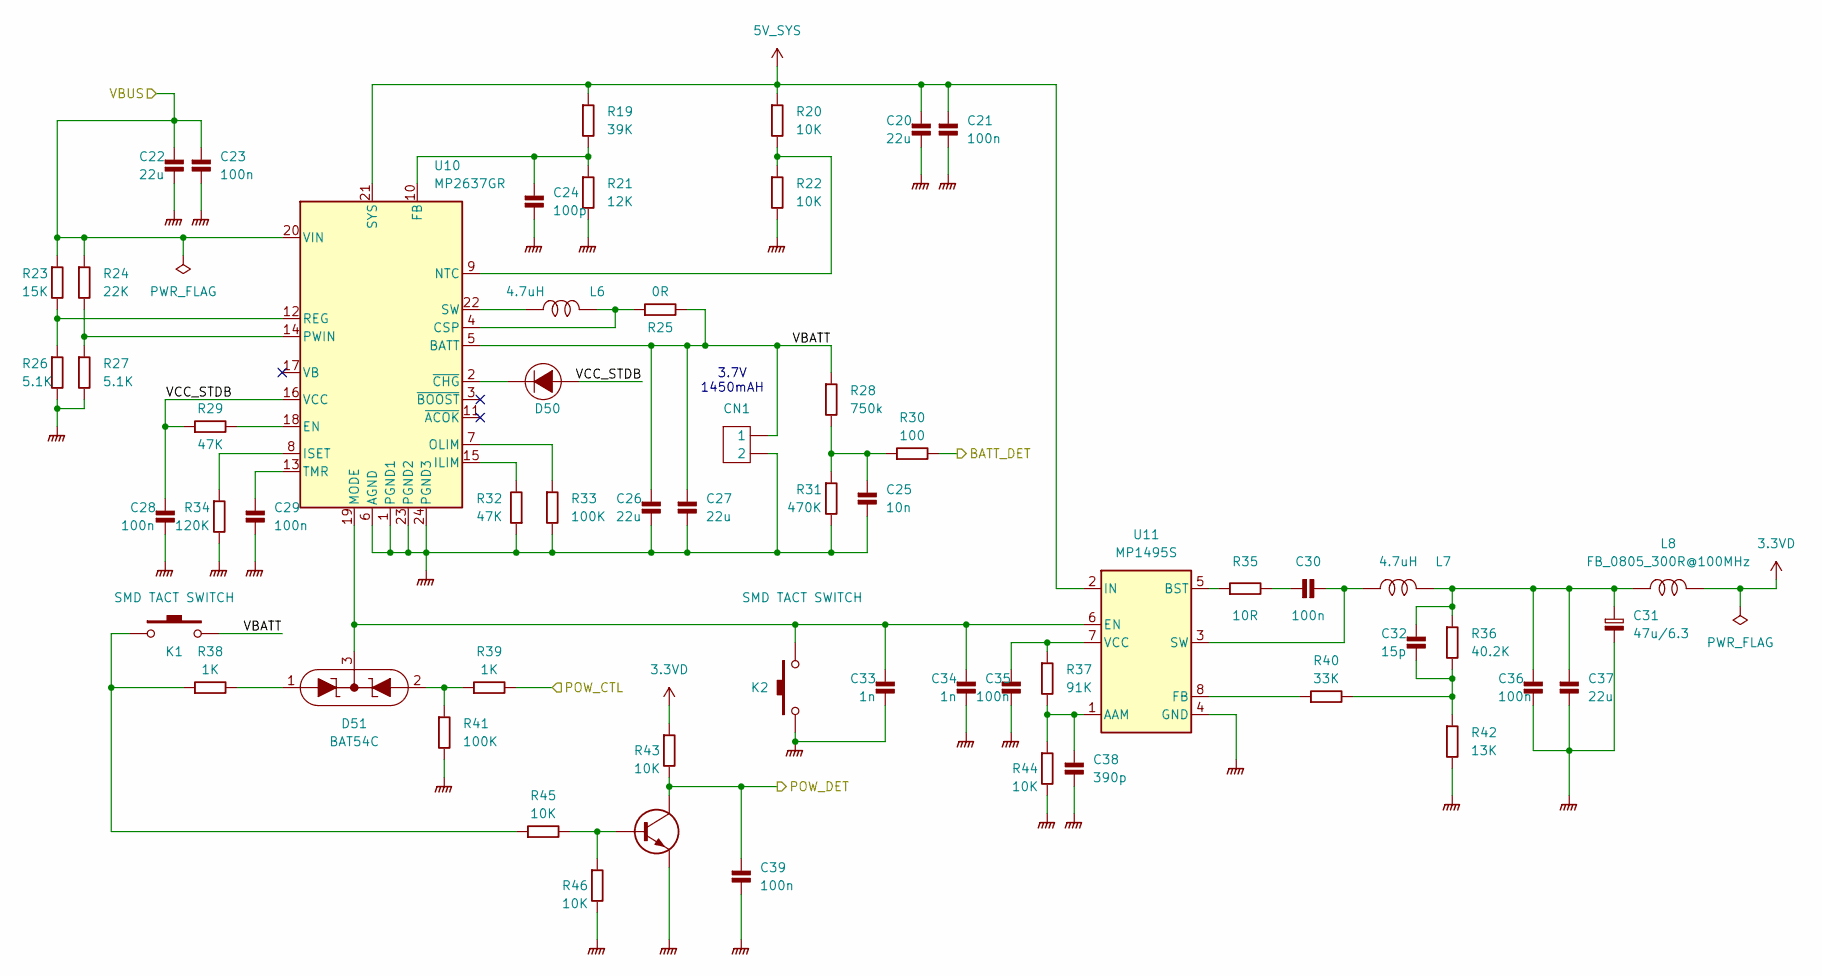
[picture p6: schematic power.kicad_sch]

Parts:
C20, C22, C26, C27, C37: 22u; C_0603_1608Metric_Pad1.08x0.95mm_HandSolder
C21, C23, C28, C29, C30, C35, C36, C39: 100n; C_0402_1005Metric_Pad0.74x0.62mm_HandSolder
C24: 100p; C_0402_1005Metric_Pad0.74x0.62mm_HandSolder
C25: 10n; C_0402_1005Metric_Pad0.74x0.62mm_HandSolder
C31: 47u/6.3; CP_Elec_4x5.4
C32: 15p; C_0402_1005Metric_Pad0.74x0.62mm_HandSolder
C33, C34: 1n; C_0402_1005Metric_Pad0.74x0.62mm_HandSolder
C38: 390p; C_0402_1005Metric_Pad0.74x0.62mm_HandSolder
CN1: Connector 1*2_2.0; 2PIN - 2.0
D50: 0402 LED; LED0402
D51: BAT54C; SOT-23-3
K1, K2: SMD TACT SWITCH; SW-T-SMT
L6, L7: 4.7uH; L_Sunlord_SWPA4020S
L8: FB_0805_300R@100MHz; R_0805_2012Metric_Pad1.20x1.40mm_HandSolder
Q2: LMBT3904LT1G; SOT-23
R19: 39K; R_0402_1005Metric_Pad0.72x0.64mm_HandSolder
R20, R22, R43, R44, R45, R46: 10K; R_0402_1005Metric_Pad0.72x0.64mm_HandSolder
R21: 12K; R_0402_1005Metric_Pad0.72x0.64mm_HandSolder
R23: 15K; R_0402_1005Metric_Pad0.72x0.64mm_HandSolder
R24: 22K; R_0402_1005Metric_Pad0.72x0.64mm_HandSolder
R25: 0R; R_1206_3216Metric_Pad1.30x1.75mm_HandSolder
R26, R27: 5.1K; R_0402_1005Metric_Pad0.72x0.64mm_HandSolder
R28: 750k; R_0603_1608Metric_Pad0.98x0.95mm_HandSolder
R29, R32: 47K; R_0402_1005Metric_Pad0.72x0.64mm_HandSolder
R30: 100; R_0402_1005Metric_Pad0.72x0.64mm_HandSolder
R31: 470K; R_0402_1005Metric_Pad0.72x0.64mm_HandSolder
R33, R41: 100K; R_0402_1005Metric_Pad0.72x0.64mm_HandSolder
R34: 120K; R_0402_1005Metric_Pad0.72x0.64mm_HandSolder
R35: 10R; R_0402_1005Metric_Pad0.72x0.64mm_HandSolder
R36: 40.2K; R_0603_1608Metric_Pad0.98x0.95mm_HandSolder
R37: 91K; R_0402_1005Metric_Pad0.72x0.64mm_HandSolder
R38, R39: 1K; R_0402_1005Metric_Pad0.72x0.64mm_HandSolder
R40: 33K; R_0402_1005Metric_Pad0.72x0.64mm_HandSolder
R42: 13K; R_0402_1005Metric_Pad0.72x0.64mm_HandSolder
U10: MP2637GR; QFN-24 (4mm×4mm)
U11: MP1495S; TSOT23-8

Connections:
3.3VD: L8.2, R43.1; also elsewhere on the board
5V_SYS: C20.1, C21.1, R19.1, R20.1, U10.21 (SYS), U11.2 (IN); also elsewhere on the board
/C6/POW_CTL: R39.2; also elsewhere on the board
/C6/POW_DET: C39.1, Q2.3 (C), R43.2; also elsewhere on the board
/core/BATT_DET: R30.2; also elsewhere on the board
/core/VBUS: C22.1, C23.1, R23.1, R24.1, U10.20 (VIN); also elsewhere on the board
/power/VBATT: C26.1, C27.1, CN1.1, K1.2, R25.2, R28.1, U10.5 (BATT)
/power/VCC_STDB: C28.1, D50.A (2), R29.1, U10.16 (VCC)
GNDPWR: C20.2, C21.2, C22.2, C23.2, C24.2, C25.2, C26.2, C27.2, C28.2, C29.2, C31.2, C33.2, C34.2, C35.2, C36.2, C37.2, C38.2, C39.2, CN1.2, K2.1, Q2.2 (E), R21.2, R22.2, R26.2, R27.2, R31.2, R32.1, R33.2, R34.2, R41.2, R42.2, R44.2, R46.2, U10.1 (PGND1), U10.6 (AGND), U10.23 (PGND2), U10.24 (PGND3), U11.4 (GND); also elsewhere on the board
unnamed: C25.1, R28.2, R30.1, R31.1
unnamed: C30.1, R35.2
unnamed: C31.1, C32.1, C36.1, C37.1, L7.2, L8.1, R36.1
unnamed: C32.2, R36.2, R40.2, R42.1
unnamed: D50.K (1), U10.2 (~CHG)
unnamed: D51.1 (A), R38.2
unnamed: D51.2 (A), R39.1, R41.1
unnamed: C33.1, C34.1, D51.3 (K), K2.2, U10.19 (MODE), U11.6 (EN)
unnamed: K1.1, R38.1, R45.1
unnamed: Q2.1 (B), R45.2, R46.1
unnamed: L6.2, R25.1, U10.4 (CSP)
unnamed: R29.2, U10.18 (EN)
unnamed: C24.1, R19.2, R21.1, U10.10 (FB)
unnamed: R32.2, U10.15 (ILIM)
unnamed: R34.1, U10.8 (ISET)
unnamed: R20.2, R22.1, U10.9 (NTC)
unnamed: R33.1, U10.7 (OLIM)
unnamed: R24.2, R27.1, U10.14 (PWIN)
unnamed: R23.2, R26.1, U10.12 (REG)
unnamed: L6.1, U10.22 (SW)
unnamed: C29.1, U10.13 (TMR)
unnamed: C38.1, R37.2, R44.1, U11.1 (AAM)
unnamed: R35.1, U11.5 (BST)
unnamed: R40.1, U11.8 (FB)
unnamed: C30.2, L7.1, U11.3 (SW)
unnamed: C35.1, R37.1, U11.7 (VCC)

Notes on the sheet:
3.7V 1450mAH

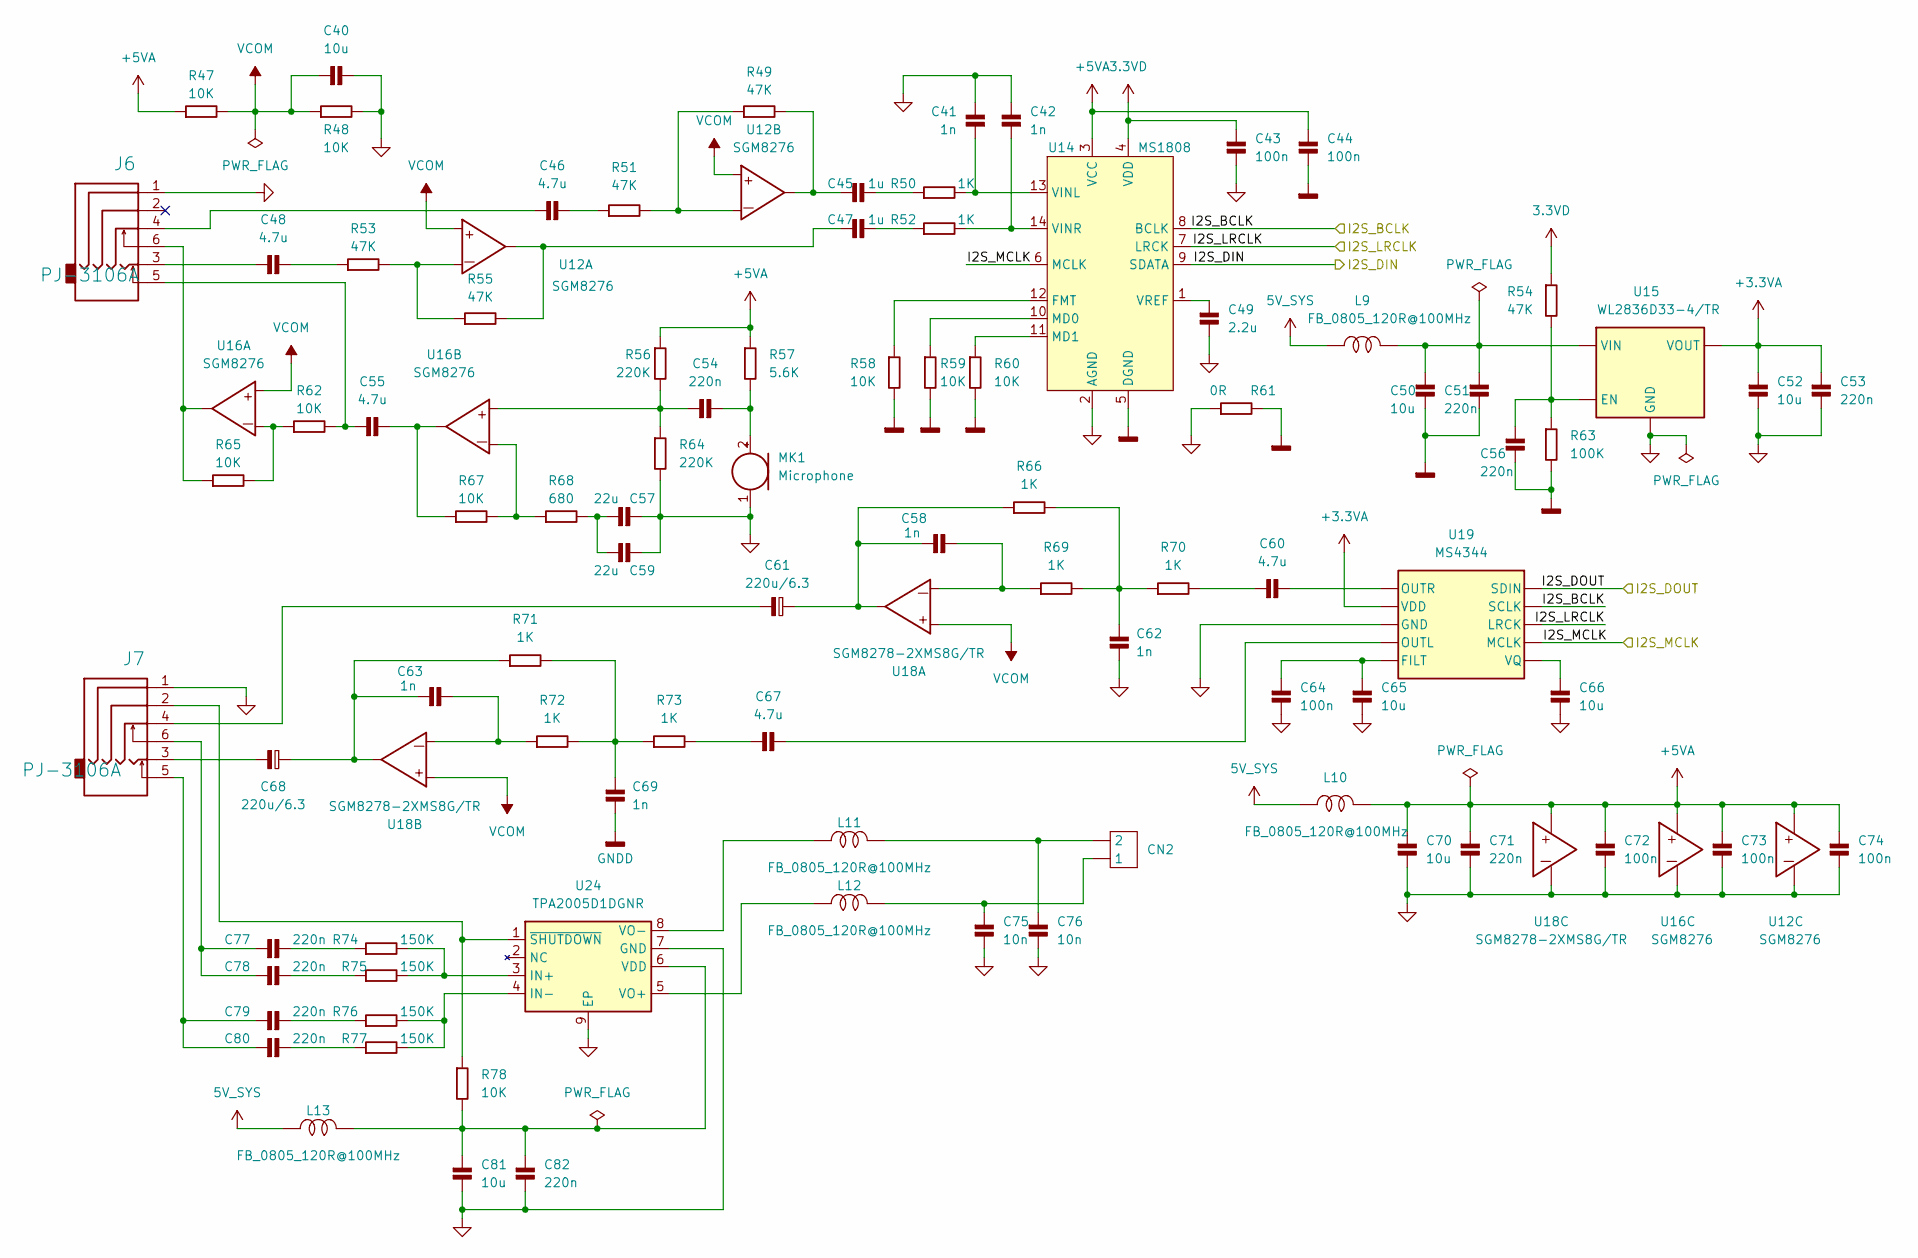
[picture p7: schematic audio.kicad_sch, Audio — MS1808 / MS4344 / Amp]

Parts:
C40, C50, C52, C65, C66, C70, C81: 10u; C_0603_1608Metric_Pad1.08x0.95mm_HandSolder
C41, C42, C58, C62, C63, C69: 1n; C_0402_1005Metric_Pad0.74x0.62mm_HandSolder
C43, C44, C64, C72, C73, C74: 100n; C_0402_1005Metric_Pad0.74x0.62mm_HandSolder
C45, C47: 1u; C_0603_1608Metric_Pad1.08x0.95mm_HandSolder
C46, C48, C55, C60, C67: 4.7u; C_0603_1608Metric_Pad1.08x0.95mm_HandSolder
C49: 2.2u; C_0402_1005Metric_Pad0.74x0.62mm_HandSolder
C51, C53, C54, C56, C71, C82: 220n; C_0603_1608Metric_Pad1.08x0.95mm_HandSolder
C57, C59: 22u; C_0603_1608Metric_Pad1.08x0.95mm_HandSolder
C61, C68: 220u/6.3; CP_Elec_6.3x5.4
C75, C76: 10n; C_0402_1005Metric_Pad0.74x0.62mm_HandSolder
C77, C78, C79, C80: 220n; C_0402_1005Metric_Pad0.74x0.62mm_HandSolder
CN2: Connector 1*2_2.0; 2PIN - 2.0
J6, J7: PJ-3106A; PJ3106A
L9, L10, L11, L12, L13: FB_0805_120R@100MHz; L_0805_2012Metric_Pad1.05x1.20mm_HandSolder
MK1: Microphone; 2PIN - 2.0
R47, R48, R58, R59, R60, R62, R65, R67, R78: 10K; R_0402_1005Metric_Pad0.72x0.64mm_HandSolder
R49, R51, R53, R54, R55: 47K; R_0402_1005Metric_Pad0.72x0.64mm_HandSolder
R50, R52, R66, R69, R70, R71, R72, R73: 1K; R_0402_1005Metric_Pad0.72x0.64mm_HandSolder
R56, R64: 220K; R_0603_1608Metric_Pad0.98x0.95mm_HandSolder
R57: 5.6K; R_0402_1005Metric_Pad0.72x0.64mm_HandSolder
R61: 0R; R_0603_1608Metric_Pad0.98x0.95mm_HandSolder
R63: 100K; R_0402_1005Metric_Pad0.72x0.64mm_HandSolder
R68: 680; R_0402_1005Metric_Pad0.72x0.64mm_HandSolder
R74, R75, R76, R77: 150K; R_0402_1005Metric_Pad0.72x0.64mm_HandSolder
U12, U16: SGM8276; SOP-8
U14: MS1808; TSSOP14; Part Number MS1808
U15: WL2836D33-4/TR; DFN1x1-4L
U18: SGM8278-2XMS8G/TR; MSOP-8; Part Number SGM5532YS8G/TR
U19: MS4344; MSOP-10
U24: TPA2005D1DGNR; Texas_DGN0008D_VSSOP-8-1EP_3x3mm_P0.65mm_EP2x2.94mm_Mask1.5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

Connections:
3.3VD: C43.1, R54.1, U14.4 (VDD); also elsewhere on the board
5V_SYS: L9.1, L10.1, L13.1; also elsewhere on the board
+3.3VA: C52.1, C53.1, U15.1 (VOUT), U19.9 (VDD)
+5VA: C44.1, C70.1, C71.1, C72.1, C73.1, C74.1, L10.2, R47.1, R56.1, R57.1, U12.8, U14.3 (VCC), U16.8, U18.8
/audio/I2S_BCLK: U14.8 (BCLK), U19.2 (SCLK); also elsewhere on the board
/audio/I2S_DIN: U14.9 (SDATA); also elsewhere on the board
/audio/I2S_DOUT: U19.1 (SDIN); also elsewhere on the board
/audio/I2S_LRCLK: U14.7 (LRCK), U19.3 (LRCK); also elsewhere on the board
/audio/I2S_MCLK: U14.6 (MCLK), U19.4 (MCLK); also elsewhere on the board
GNDA: C40.2, C41.2, C42.2, C43.2, C49.2, C52.2, C53.2, C57.2, C59.2, C62.2, C64.2, C65.2, C66.2, C70.2, C71.2, C72.2, C73.2, C74.2, C75.2, C76.2, C81.2, C82.2, J6.1, J7.1, MK1.1 (-), R48.2, R61.1, R64.2, U12.4, U14.2 (AGND), U15.2 (GND), U15.5 (GNDA), U16.4, U18.4, U19.8 (GND), U24.7 (GND), U24.9 (EP)
GNDD: C44.2, C50.2, C51.2, C56.2, C69.2, R58.2, R59.2, R60.2, R61.2, R63.2, U14.5 (DGND); also elsewhere on the board
unnamed: C45.1, R50.1
unnamed: C45.2, R49.2, U12.7
unnamed: C46.1, J6.4
unnamed: C46.2, R51.1
unnamed: C47.1, R52.1
unnamed: C47.2, R55.2, U12.1
unnamed: C48.1, J6.3
unnamed: C48.2, R53.1
unnamed: C54.1, R56.2, R64.1, U16.5
unnamed: C55.1, J6.5, R62.2
unnamed: C55.2, R67.1, U16.7
unnamed: C57.1, C59.1, R68.2
unnamed: C58.1, C61.1, R66.1, U18.1
unnamed: C58.2, R69.1, U18.2
unnamed: C60.1, R70.2
unnamed: C61.2, J7.4
unnamed: C62.1, R66.2, R69.2, R70.1
unnamed: C63.1, C68.1, R71.1, U18.7
unnamed: C63.2, R72.1, U18.6
unnamed: C67.1, R73.2
unnamed: C68.2, J7.3
unnamed: C69.1, R71.2, R72.2, R73.1
unnamed: C75.1, CN2.1, L12.2
unnamed: C76.1, CN2.2, L11.2
unnamed: C77.1, C78.1, J7.6
unnamed: C77.2, R74.1
unnamed: C78.2, R75.1
unnamed: C79.1, C80.1, J7.5
unnamed: C79.2, R76.1
unnamed: C80.2, R77.1
unnamed: J6.6, R65.1, U16.1
unnamed: C54.2, MK1.2 (+), R57.2
unnamed: R49.1, R51.2, U12.6
unnamed: R53.2, R55.1, U12.2
unnamed: R62.1, R65.2, U16.2
unnamed: R67.2, R68.1, U16.6
unnamed: R58.1, U14.12 (FMT)
unnamed: R59.1, U14.10 (MD0)
unnamed: R60.1, U14.11 (MD1)
unnamed: C41.1, R50.2, U14.13 (VINL)
unnamed: C42.1, R52.2, U14.14 (VINR)
unnamed: C49.1, U14.1 (VREF)
unnamed: C56.1, R54.2, R63.1, U15.3 (EN)
unnamed: C50.1, C51.1, L9.2, U15.4 (VIN)
unnamed: C64.1, C65.1, U19.6 (FILT)
unnamed: C67.2, U19.7 (OUTL)
unnamed: C60.2, U19.10 (OUTR)
unnamed: C66.1, U19.5 (VQ)
unnamed: R74.2, R75.2, U24.3 (IN+)
unnamed: R76.2, R77.2, U24.4 (IN-)
unnamed: C81.1, C82.1, L13.2, R78.2, U24.6 (VDD)
unnamed: L12.1, U24.5 (VO+)
unnamed: L11.1, U24.8 (VO-)
unnamed: J7.2, R78.1, U24.1 (~SHUTDOWN)
VCOM: C40.1, R47.2, R48.1, U12.3, U12.5, U16.3, U18.3, U18.5
