guthmanny/feahi_rp2350/hardware/profiles/sp-1/kicad/sp-1.kicad_pcb

## KiCad design hardware/profiles/sp-1/kicad/sp-1.kicad_pcb (continued)

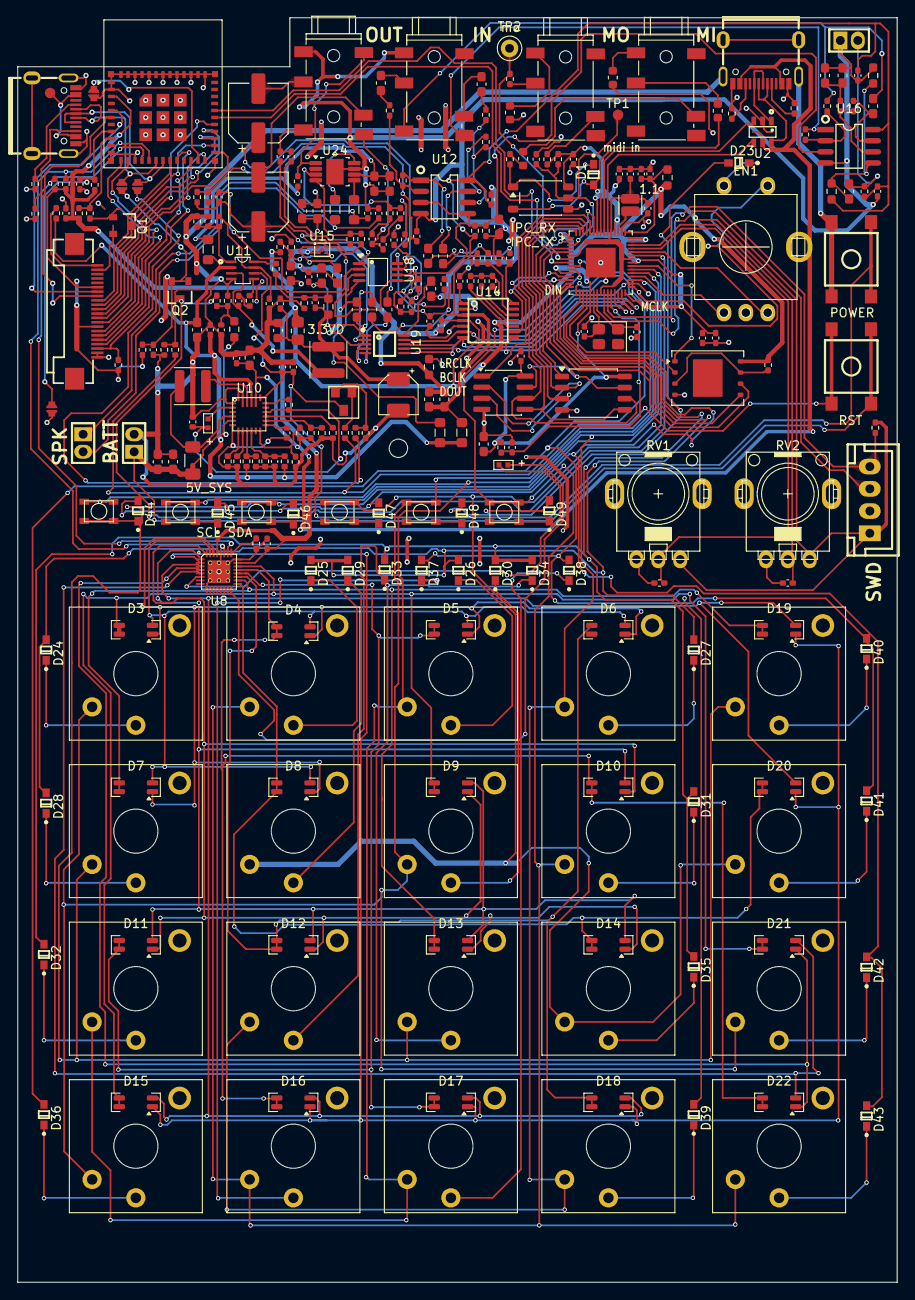
[picture p8: board sp-1.kicad_pcb from above]

Board: 2 copper layers, 100.5 x 144.5 mm, 295 parts (0 on the bottom side), 220 nets.
