guthmanny/feahi_rp2350/hardware/profiles/b-c6/kicad/sp1_cbi40_periph/sheets/periph_audio.kicad_sch

## KiCad design hardware/profiles/b-c6/kicad/sp1_cbi40_periph/sheets/periph_audio.kicad_sch (2026-10-20)

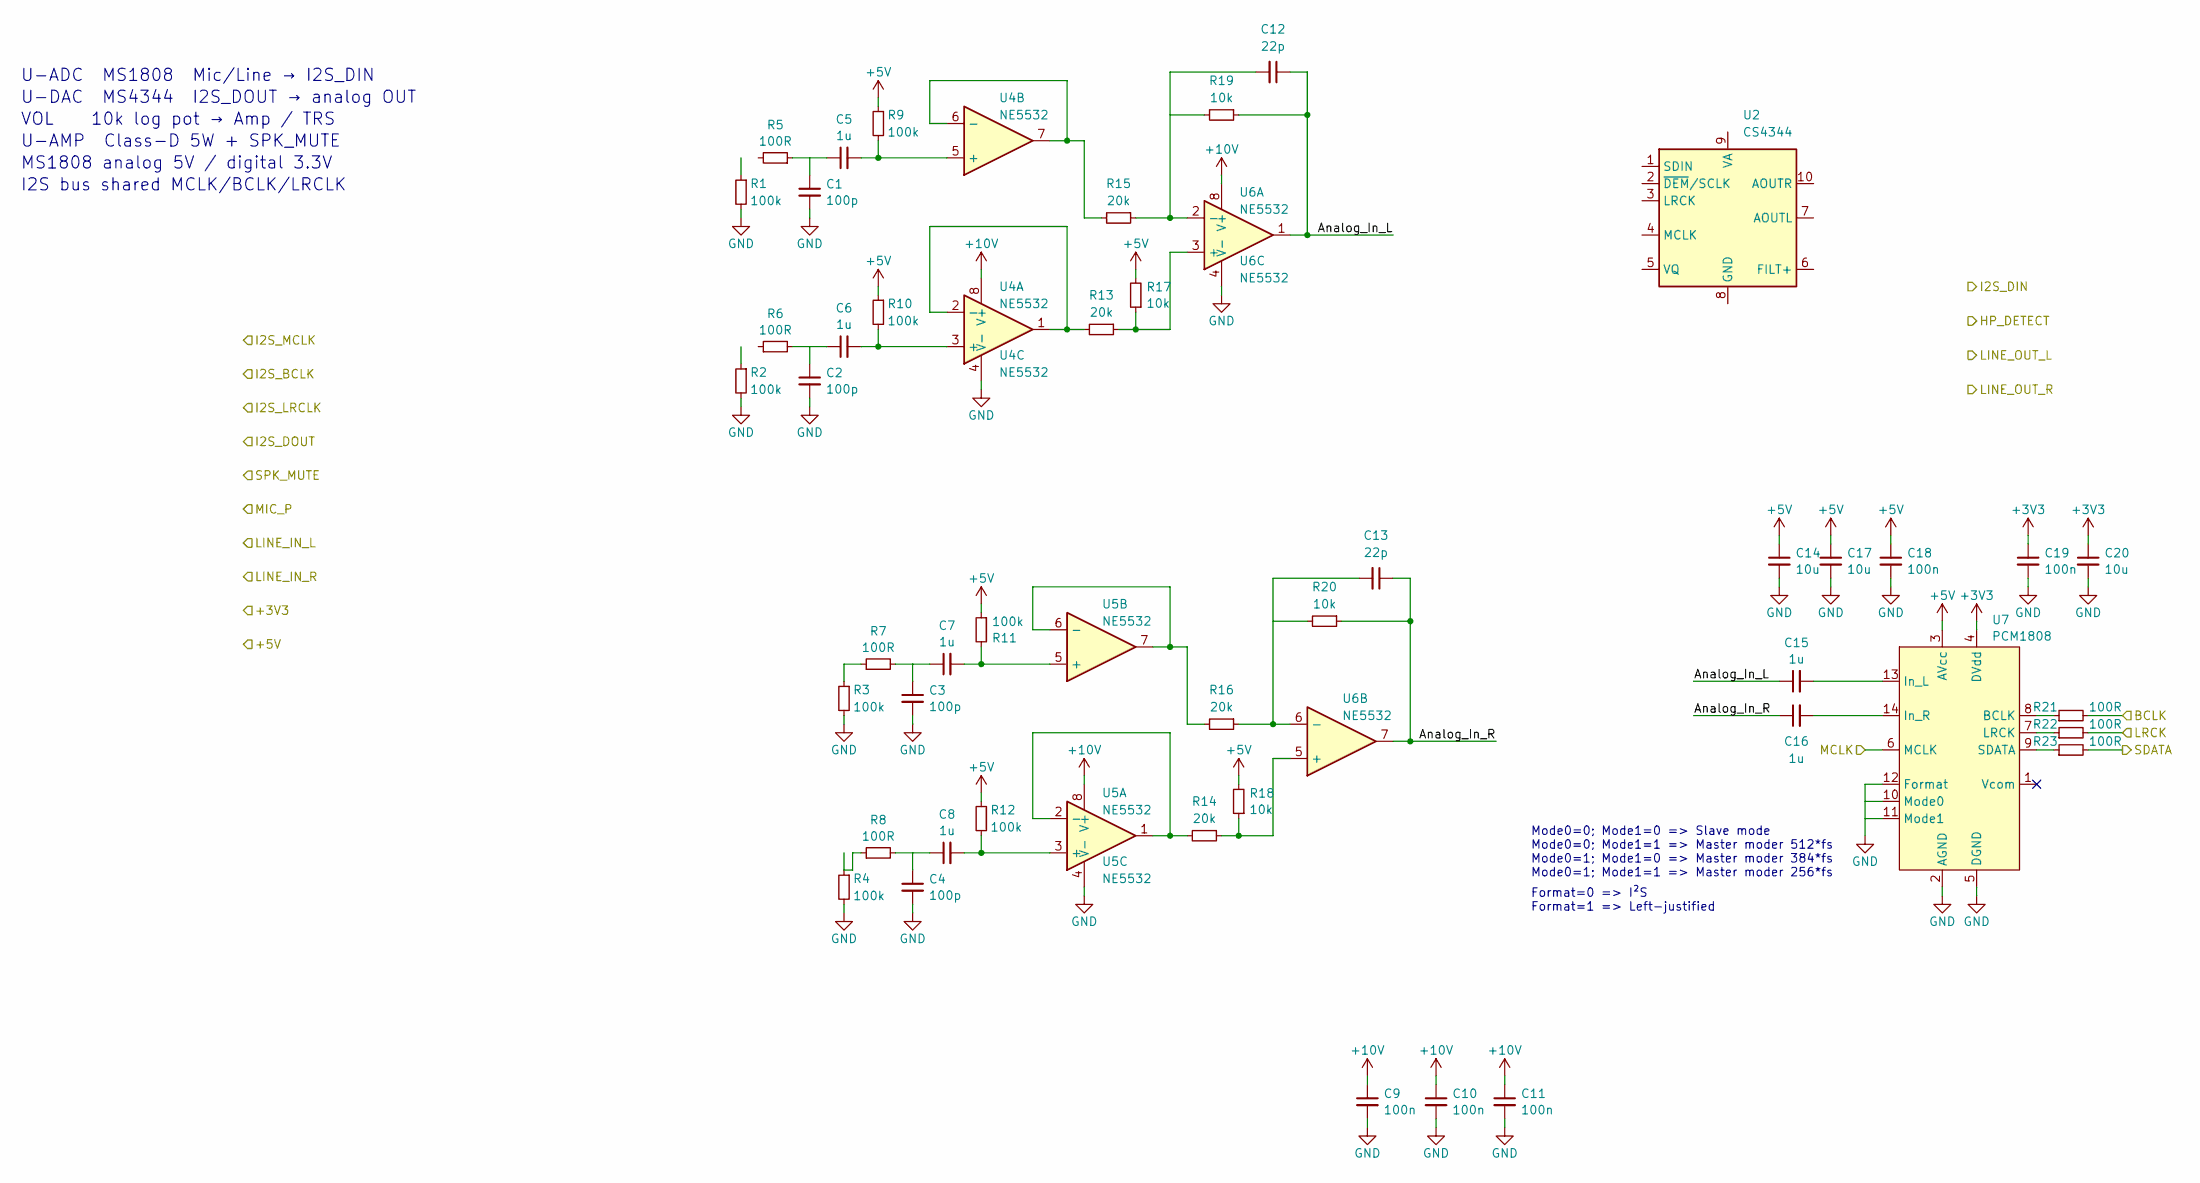
[picture p9: schematic periph_audio.kicad_sch]

Parts:
C1, C2, C3, C4: 100p; C_0402_1005Metric; Rated Voltage 50V; Tolerance 5%; Part Number 0402CG101J500NT; LCSC Part # C1546
C5, C6, C7, C8, C15, C16: 1u; C_1206_3216Metric; Rated Voltage 50V; Tolerance 10%; Part Number CL31B105KBHNNNE; LCSC Part # C1848
C9, C10, C11, C18, C19: 100n; C_0402_1005Metric; Rated Voltage 50V; Tolerance 10%; Part Number CL05B104KB54PNC; LCSC Part # C307331
C12, C13: 22p; C_0402_1005Metric; Rated Voltage 50V; Tolerance 5%; Part Number 0402CG220J500NT; LCSC Part # C1555
C14, C17, C20: 10u; C_0603_1608Metric; Rated Voltage 25V; Tolerance 10%; Part Number CL10A106MA8NRNC; LCSC Part # C96446
R1, R2, R3, R4, R9, R10, R11, R12: 100k; R_0402_1005Metric; Tolerance 1%; Part Number 0402WGF1003TCE; LCSC Part # C25741
R5, R6, R7, R8, R21, R22, R23: 100R; R_0402_1005Metric; Tolerance 1%; Part Number 0402WGF1000TCE; LCSC Part # C25076
R13, R14, R15, R16: 20k; R_0402_1005Metric; Tolerance 1%; Part Number 0402WGF2002TCE; LCSC Part # C25765
R17, R18, R19, R20: 10k; R_0402_1005Metric; Tolerance 1%; Part Number 0402WGF1002TCE; LCSC Part # C25744
U2: CS4344; TSSOP-10_3x3mm_P0.5mm
U4, U5, U6: NE5532; SOIC-8_3.9x4.9mm_P1.27mm; Part Number NE5532DR; LCSC Part # C7426
U7: PCM1808; TSSOP-14_4.4x5mm_P0.65mm; Part Number PCM1808PWR

Connections:
+3V3: C19.1, C20.1, U7.4 (DVdd)
+5V: C14.1, C17.1, C18.1, R9.1, R10.1, R11.1, R12.1, R17.2, R18.2, U7.3 (AVcc)
+10V: C9.1, C10.1, C11.1, U4.8 (V+), U5.8 (V+), U6.8 (V+)
Analog_In_L: C12.1, C15.1, R19.1, U6.1
Analog_In_R: C13.1, C16.1, R20.1, U6.7
BCLK: R21.2
GND: C1.2, C2.2, C3.2, C4.2, C9.2, C10.2, C11.2, C14.2, C17.2, C18.2, C19.2, C20.2, R1.2, R2.2, R3.2, R4.2, U4.4 (V-), U5.4 (V-), U6.4 (V-), U7.2 (AGND), U7.5 (DGND), U7.12 (Format)
LRCK: R22.2
MCLK: U7.6 (MCLK)
unnamed: C5.1, R5.1
unnamed: C5.2, R9.2, U4.5 (+)
unnamed: C6.1, R6.2
unnamed: C6.2, R10.2, U4.3 (+)
unnamed: C7.1, R7.2
unnamed: C7.2, R11.2, U5.5 (+)
unnamed: C8.1, R8.2
unnamed: C8.2, R12.2, U5.3 (+)
unnamed: C12.2, R15.1, U6.2 (-)
unnamed: C13.2, R16.1, U6.6 (-)
unnamed: C15.2, U7.13 (In_L)
unnamed: C16.2, U7.14 (In_R)
unnamed: R3.1, R7.1
unnamed: R4.1, R8.1
unnamed: R13.1, R17.1, U6.3 (+)
unnamed: R13.2, U4.1, U4.2 (-)
unnamed: R14.1, R18.1, U6.5 (+)
unnamed: R14.2, U5.1, U5.2 (-)
unnamed: R15.2, U4.6 (-), U4.7
unnamed: R16.2, U5.6 (-), U5.7
unnamed: R21.1, U7.8 (BCLK)
unnamed: R22.1, U7.7 (LRCK)
unnamed: R23.1, U7.9 (SDATA)
SDATA: R23.2

Notes on the sheet:
U-DAC MS4344 I2S_DOUT → analog OUT
Format=0 => I²S Format=1 => Left-justified
I2S bus shared MCLK/BCLK/LRCLK
U-AMP Class-D 5W + SPK_MUTE
Mode0=0; Mode1=0 => Slave mode Mode0=0; Mode1=1 => Master moder 512*fs Mode0=1; Mode1=0 => Master moder 384*fs Mode0=1; Mode1=1 => Master moder 256*fs
VOL 10k log pot → Amp / TRS
U-ADC MS1808 Mic/Line → I2S_DIN
MS1808 analog 5V / digital 3.3V
