guthmanny/feahi_rp2350/hardware/profiles/b-c6/kicad/sp1_cbi40_periph/sheets/periph_c6.kicad_sch

## KiCad design hardware/profiles/b-c6/kicad/sp1_cbi40_periph/sheets/periph_c6.kicad_sch (2026-10-20)

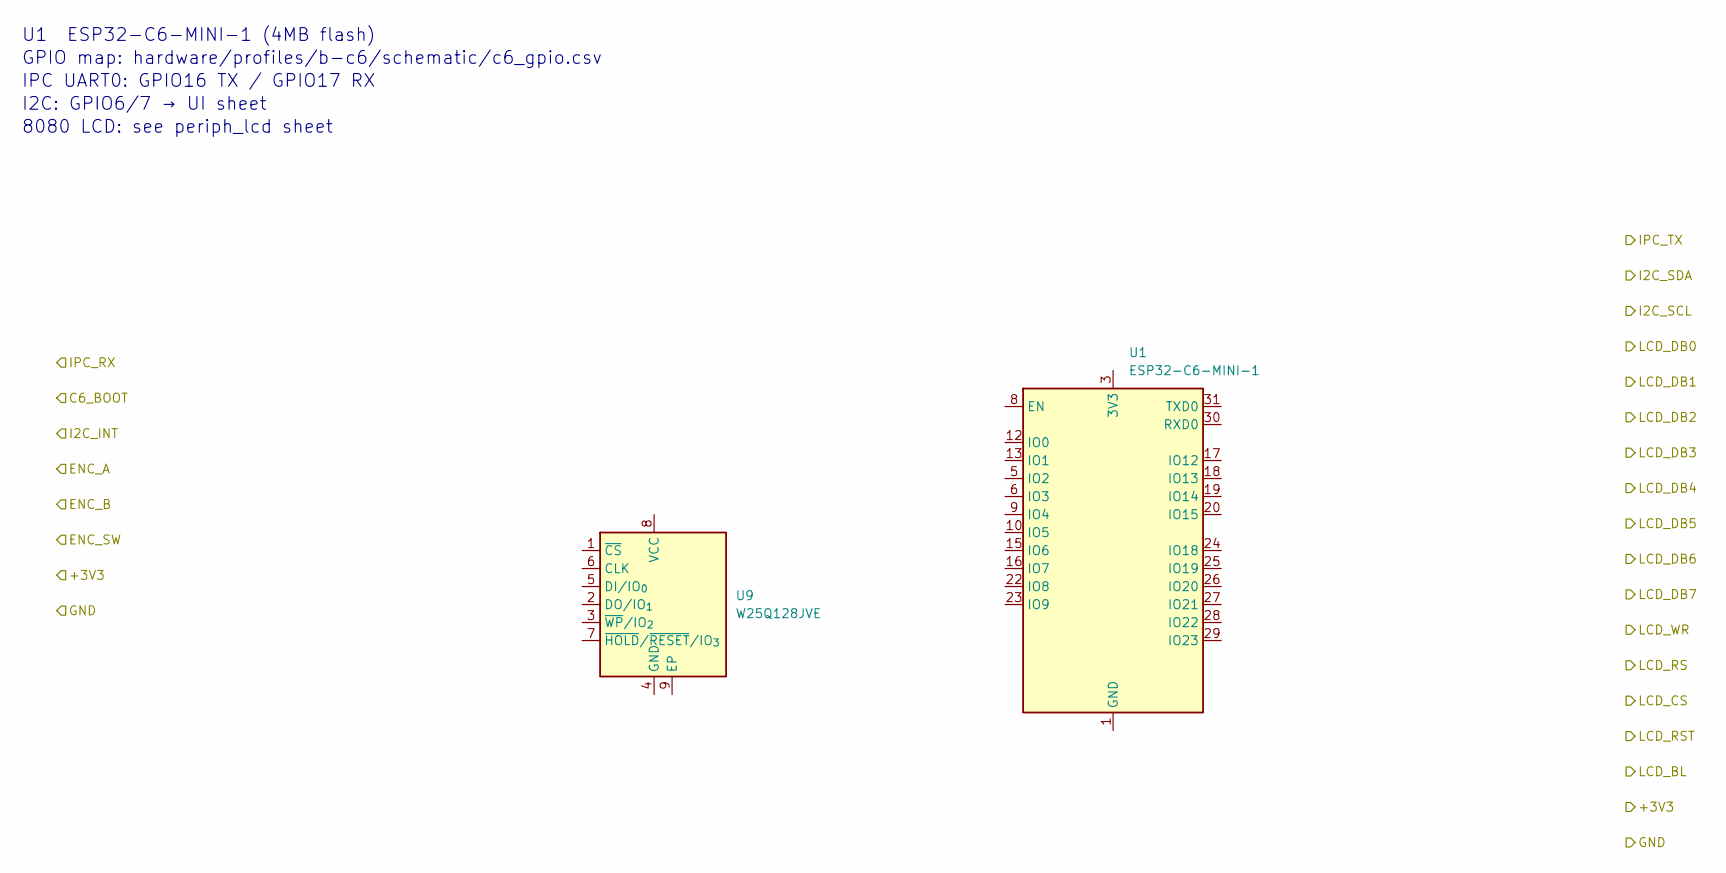
[picture p10: schematic periph_c6.kicad_sch]

Parts:
U1: ESP32-C6-MINI-1
U9: W25Q128JVE; WSON-8-1EP_8x6mm_P1.27mm_EP3.4x4.3mm

Connections:
unnamed: U1.1 (GND), U1.2 (GND), U1.11 (GND), U1.14 (GND), U1.36 (GND), U1.37 (GND), U1.38 (GND), U1.39 (GND), U1.40 (GND), U1.41 (GND), U1.42 (GND), U1.43 (GND), U1.44 (GND), U1.45 (GND), U1.46 (GND), U1.47 (GND), U1.48 (GND), U1.49 (GND), U1.50 (GND), U1.51 (GND), U1.52 (GND), U1.53 (GND)

Notes on the sheet:
IPC UART0: GPIO16 TX / GPIO17 RX
I2C: GPIO6/7 → UI sheet
GPIO map: hardware/profiles/b-c6/schematic/c6_gpio.csv
U1 ESP32-C6-MINI-1 (4MB flash)
8080 LCD: see periph_lcd sheet
