guthmanny/feahi_rp2350/hardware/profiles/b-c6/kicad/sp1_cbi40_periph/sheets/periph_conn.kicad_sch

## KiCad design hardware/profiles/b-c6/kicad/sp1_cbi40_periph/sheets/periph_conn.kicad_sch (2026-10-20)

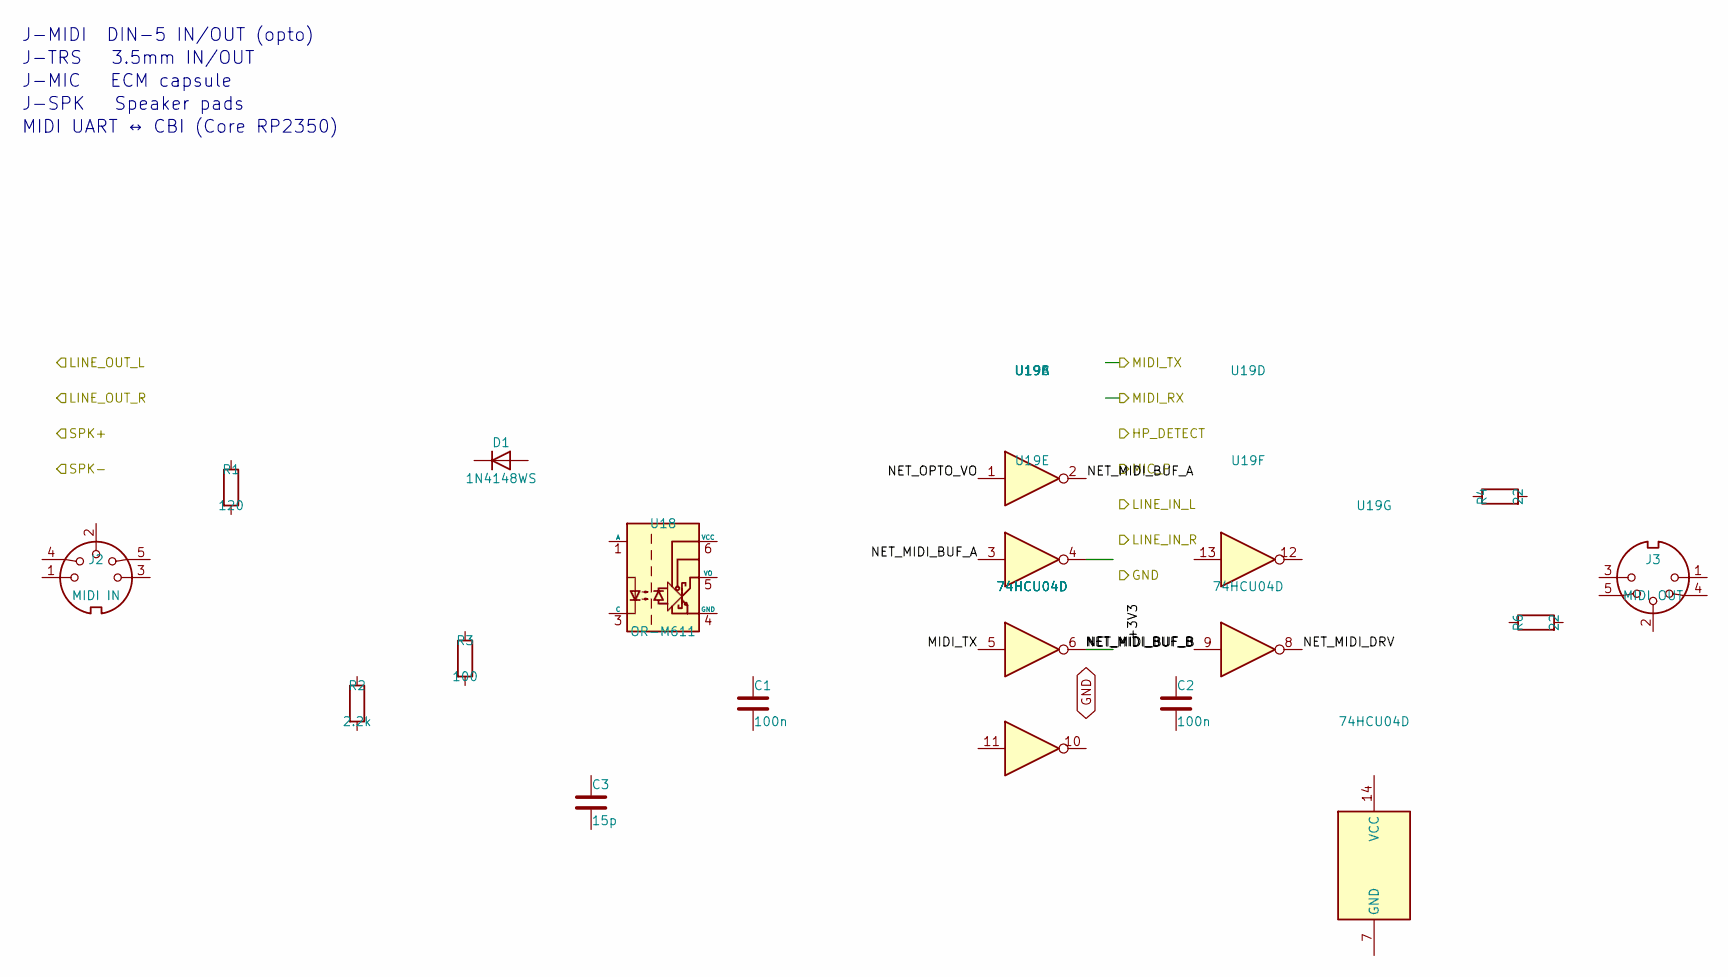
[picture p11: schematic periph_conn.kicad_sch]

Parts:
C1, C2: 100n; C_0402_1005Metric
C3: 15p; C_0402_1005Metric
D1: 1N4148WS; D_SOD-323
J2: MIDI IN
J3: MIDI OUT
R1: 120; R_0402_1005Metric
R2: 2.2k; R_0402_1005Metric
R3: 100; R_0402_1005Metric
R4, R6: 22; R_0402_1005Metric
U18: OR-M611; SO-5-6_4.55x3.7mm_P1.27mm; Part Number OR-M611-TP-G-(HB)
U19: 74HCU04D; SOIC-14_3.9x8.7mm_P1.27mm; Part Number 74HCU04D

Connections:
MIDI_TX: U19.5
NET_MIDI_BUF_A: U19.2, U19.3
NET_MIDI_BUF_B: U19.6, U19.9
NET_MIDI_DRV: U19.8
NET_OPTO_VO: U19.1

Notes on the sheet:
J-SPK Speaker pads
J-MIDI DIN-5 IN/OUT (opto)
J-TRS 3.5mm IN/OUT
MIDI UART ↔ CBI (Core RP2350)
J-MIC ECM capsule
