guthmanny/feahi_rp2350/hardware/profiles/b-c6/kicad/sp1_cbi40_periph/sheets/periph_ui.kicad_sch

## KiCad design hardware/profiles/b-c6/kicad/sp1_cbi40_periph/sheets/periph_ui.kicad_sch (2026-10-20)

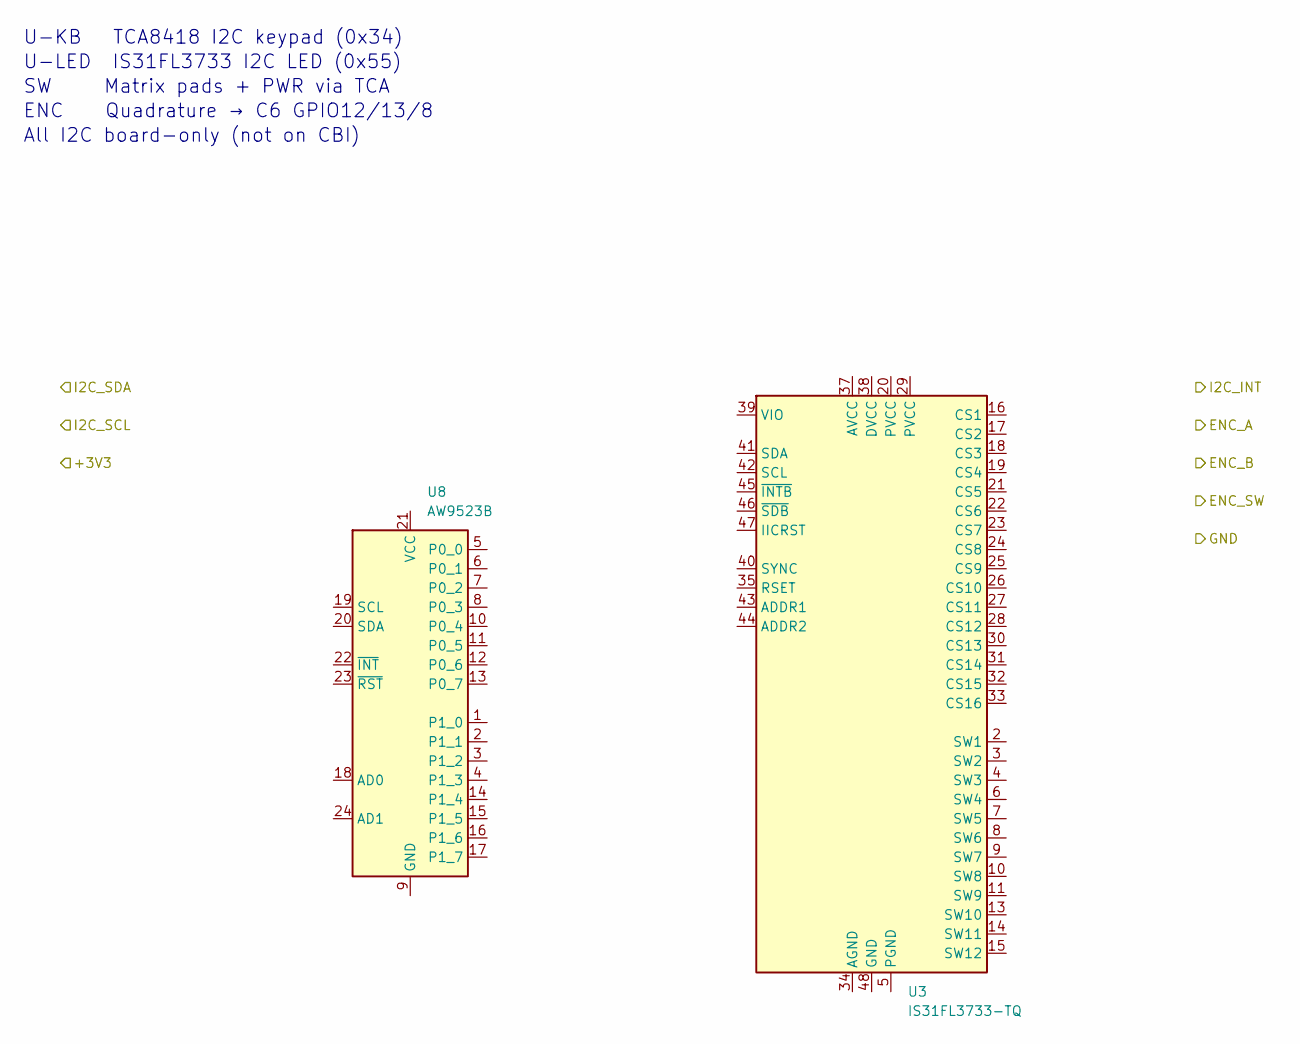
[picture p12: schematic periph_ui.kicad_sch]

Parts:
U3: IS31FL3733-TQ; TQFP-48-1EP_7x7mm_P0.5mm_EP5x5mm
U8: AW9523B; QFN-24-1EP_4x4mm_P0.5mm_EP2.7x2.7mm

Connections:
unnamed: U3.5 (PGND), U3.12 (PGND)
unnamed: U3.48 (GND), U3.49 (GND)
unnamed: U8.9 (GND), U8.25 (GND)

Notes on the sheet:
All I2C board-only (not on CBI)
U-KB TCA8418 I2C keypad (0x34)
U-LED IS31FL3733 I2C LED (0x55)
SW Matrix pads + PWR via TCA
ENC Quadrature → C6 GPIO12/13/8
