guthmanny/feahi_rp2350/(commit log)

2026-09-16 Initial commit: SP-1 dual-chip firmware and hardware scaffold.
    Add RP2350/C6 project structure, CBI-40 KiCad templates, schematic nets, BOM, and MIDI IN/OUT on PERIPH-1.
    [BOM_IC.csv, c6_gpio.csv, cbi40_pinout.csv, core_cbi.kicad_sch, core_mcu.kicad_sch, core_nand.kicad_sch, core_power.kicad_sch, core_usb.kicad_sch]
2026-09-29 Add the SP-1 KiCad design and drop the unused CBI40 scaffold.
    Point symbols and footprints at the project libraries, and stop tracking KiCad restore backups and ERC reports.
    [BOM_IC.csv, audio.kicad_sch, c6.kicad_sch, c6_gpio.csv, core.kicad_sch, core_cbi.kicad_sch, core_mcu.kicad_sch, core_nand.kicad_sch]
2026-10-20 Restructure repository as SP-1 product layout.
    Move firmware to targets/rp2350-c6, hardware to profiles/b-c6, rename KiCad projects to sp1_cbi40_* and symbol library to sp1.kicad_sym, add spec/ipc.md.
2026-10-20 Add SP-1 platform-neutral product spec (0.1.0-draft).
    Document intents, voice/sample refs, FX catalog, IPC envelope, and binding template; clarify spec vs profile in README and architecture.
2026-10-31 Restore the later SP-1 board, schematics, and footprint libraries after the profile move.
    The product-layout rebase left the older first-add PCB in profiles/sp-1 and dropped the clearance, top-mount LED, and vendored library paths.
